emanuelenencioni/CORE23/Docs/ReportSWE4ES.docx

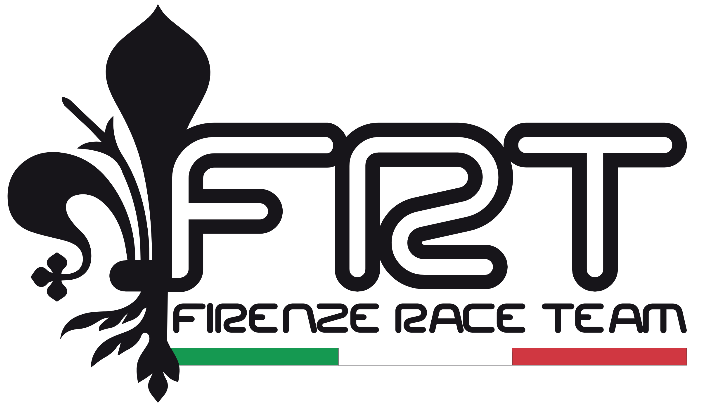
[picture p1: figure]

COMBUSTION & DRIVERLESS

FR-24

Sviluppo e Analisi Dettagliata del Software per la Main Control Unit nelle Applicazioni di Formula SAE

Candidati

Lorenzo Porcheddu

Emanuele Nencioni

Docente

Prof. Laura Carnevali

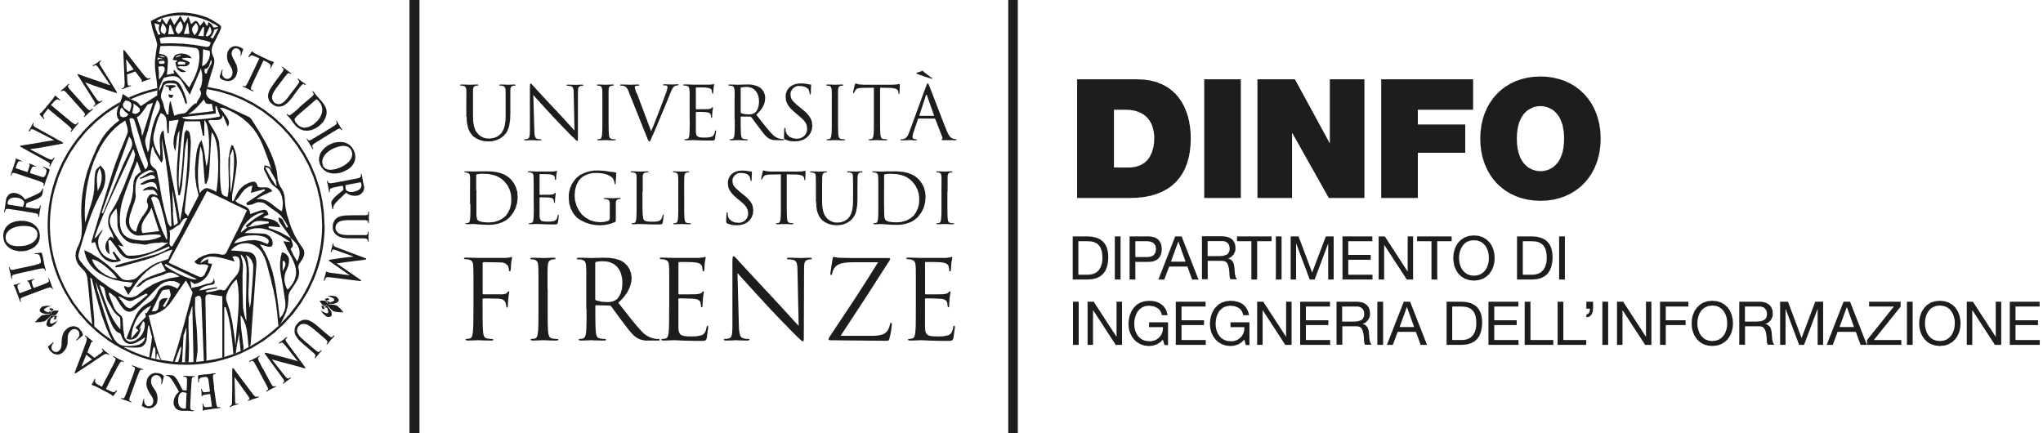
[picture p2: figure]

# Introduzione

Il Firenze Race Team è la squadra ufficiale di Formula SAE e Formula Student dell’Università degli Studi di Firenze.

È un laboratorio didattico aperto agli studenti di tutte le facoltà dell’ateneo con lo scopo di progettare e realizzare una monoposto da competizione.

Visti i prossimi cambiamenti di regolamento delle competizioni di Formula Student e il futuro del mercato automobilistico, il Team ha iniziato a sviluppare il progetto di auto a guida autonoma.

L’obiettivo principale è quello di partecipare nel 2024 alla competizione di FS-East con la vettura a combustione, per poi scendere in pista nella categoria 1D di Formula ATA con la vettura driverless.

Canditati

Emanuele Nencioni: Head of Autonomous Department – Vision & System Integration

Lorenzo Porcheddu: Head of Electronics & Controls Department

# Presentazione del Progetto e Obiettivi

La Formula Student è una competizione internazionale in cui squadre di studenti universitari si sfidano nella progettazione e costruzione di automobili da corsa monoposto. In questo progetto di Software Engineering, ci concentreremo sulla programmazione di una scheda elettronica personalizzata per un'auto da competizione, che combina le caratteristiche di un'automobile a combustione con tecnologie driverless.

L'obiettivo principale di questo progetto è sviluppare un sistema di controllo elettronico in grado di gestire il funzionamento del motore, la gestione delle velocità, il controllo del volante, il sistema di frenata, la gestione dell'alimentazione e altre funzionalità essenziali per garantire prestazioni ottimali e sicurezza durante la gara.

La sfida principale consiste nella progettazione di un software che consenta all'auto di operare autonomamente, all'interno dei limiti di velocità e parametri definiti. Ciò richiederà l'integrazione di algoritmi di intelligenza artificiale, sensori avanzati, percezione dell'ambiente e decisioni di guida autonoma.

La scheda elettronica personalizzata dovrà gestire la comunicazione bidirezionale tra l'unità di controllo principale dell'automobile e i vari componenti elettronici, come il sistema di alimentazione, l'impianto di scarico, i sistemi di raffreddamento, i sensori ambientali e molti altri. La programmazione dovrà garantire una corretta interpretazione dei dati forniti dai sensori e una risposta tempestiva per garantire efficienza, sicurezza e prestazioni ottimali.

L'interazione con il pilota sarà un altro aspetto cruciale del progetto. La scheda elettronica dovrà fornire informazioni in tempo reale al pilota, come la velocità dell'auto, lo stato del motore, la temperatura e altre informazioni critiche. Sarà necessario sviluppare un'interfaccia utente intuitiva che permetta al pilota di monitorare e intervenire nel funzionamento dell'auto driverless, garantendo una guida sicura e precisa durante la competizione.

In conclusione, questo progetto di Software Engineering, riguardante la programmazione di una scheda elettronica per la Formula Student, rappresenta una sfida entusiasmante e complessa. Il suo obiettivo principale è sviluppare un sistema sofisticato in grado di controllare in modo autonomo un'automobile a combustione durante la competizione, garantendo sicurezza, efficienza e prestazioni ottimali. L'innovazione tecnologica e l'integrazione di diverse discipline quali l'ingegneria elettronica, l'intelligenza artificiale e la sicurezza informatica saranno fondamentali per il successo di questo progetto.

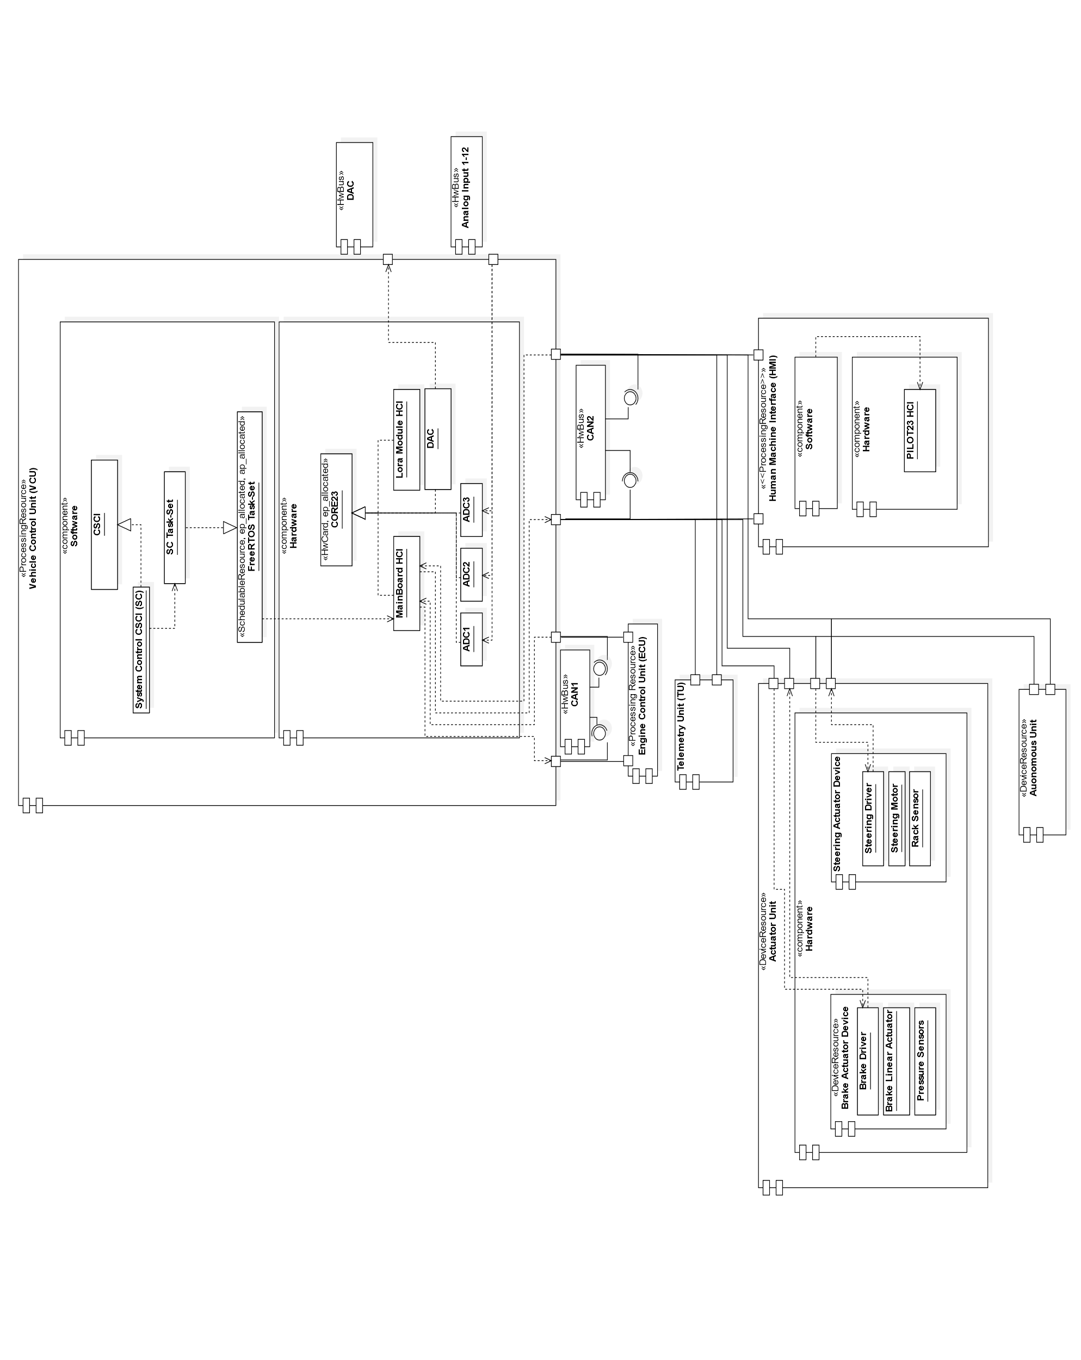
[picture p3: figure]

# Architettura del Veicolo

Come si può vedere dal diagramma di alto livello, la nostra auto integra diverse centraline elettroniche. Sono presenti anche due linee CAN bus per interconnettere il tutto, una dedicata principalmente al motore e l’altra invece al sistema autonomo. Questa suddivisione si rende necessaria data la limitata larghezza di banda disponibile, pari a 1Mbit/s di massimo teorico per ogni linea. In realtà si cerca di non superare il 50% della banda in condizioni normali per evitare la saturazione del bus e il conseguente rallentamento di tutti i messaggi.

Di seguito andiamo ad elencare i componenti del nostro sistema:

- CORE23: si tratta della MCU (Main Control Unit), ovvero della scheda principale di controllo del veicolo. Tutte le altre centraline fanno sempre riferimento a lei per gestire le funzioni interconnesse. Possiede 40 tra ingressi e uscite, analogiche e digitali, che ci permettono di collegare una buona quantità di sensori. Avendo entrambe le linee CAN bus, può essere in grado di leggere una grande quantità di dati, anche dai sensori non collegati direttamente a lei. Per esempio, può leggere la temperatura del motore dalla ECU (Engine Control Unit) e inviarla alla scheda del volante, la PILOT23, per far sì che il pilota possa monitorarla. Viceversa, può leggere il segnale proveniente dal pedale dell’acceleratore e inviarlo alla ECU, che poi lo elaborerà secondo varie strategie per attuare la valvola a farfalla. Su questa scheda si concentrerà lo sviluppo del software, quindi per ora non ci dilunghiamo molto.
- PILOT23: si tratta della HMI del veicolo, infatti è posizionata dentro il volante e si occupa principalmente di gestire l’interazione con il pilota. Sul volante è posto un display, attraverso il quale si possono visualizzare varie informazioni come marcia inserita, velocità, giri motore, temperatura dell’acqua, tempo su giro, ecc. Inoltre, si occupa di leggere i pulsanti ma soprattutto i paddle e la leva della frizione, fondamentali per interagire con il cambio.
- MekTronic MKE7: si tratta della ECU (Engine Control Unit). Come suggerisce il nome, è la centralina che si occupa della gestione del motore a combustione interna; ad essa sono infatti collegati tutti i sensori del motore, come temperatura acqua, pressione turbo, ecc. Possiede una linea CAN per l’interfacciamento con il resto del veicolo, attraverso la quale invia tutta la telemetria del motore in tempo reale.
- Driver Freno: si tratta della scheda atta a gestire il motore del freno, è collegata alla linea CAN per ricevere istruzioni ed inviare dati sul suo funzionamento.
- Driver Sterzo: si tratta della scheda atta a gestire il motore dello sterzo, è collegata alla linea CAN per ricevere istruzioni ed inviare dati sul suo funzionamento.
- AIM EVO 5: si tratta della scheda che ha il compito di registrare e memorizzare tutte le informazioni del veicolo, in tempo reale. Memorizza tutti i dati inviati su entrambe le linee CAN, inoltre ha diversi sensori aggiuntivi collegati, i quali vengono letti e memorizzati. Alla bisogna è possibile inviare i dati di questi sensori sulle linee CAN.
- PC autonomo: si tratta di un PC industriale rugged, in grado di eseguire tantissime operazioni riguardanti il sistema autonomo. Attualmente esegue ROS1 su Ubuntu 20.04, ma si progetta un futuro update a ROS2 per migliorare prestazioni e compatibilità. Monta un Intel Core i7-9700 e una scheda video NVIDIA GTX1650.

# Task set e Activity Diagram

Abbiamo quindi redatto un Activity Diagram, usando il software StarUML.

Data la dimensione del diagramma stesso, lo alleghiamo al presente report.

Di seguito, andiamo a descrivere i singoli task e le relative funzionalità

## Pedal Task

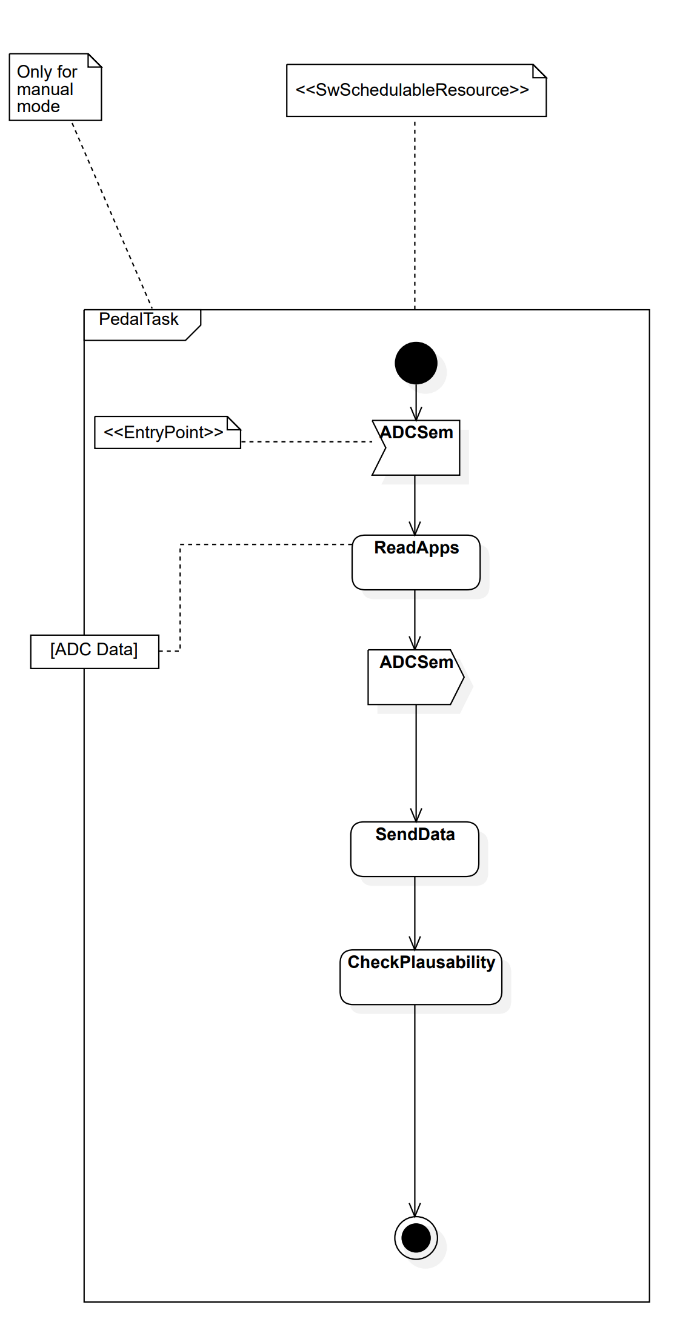
[picture p4: figure]

Si tratta del task che si occupa della gestione del comando acceleratore, inviato poi al motore a combustione. Funziona solamente durante la modalità manuale, perché durante quella autonoma si utilizza un altro task. Si prende il semaforo sull’ADC per leggere il pedale dell’acceleratore, mandiamo quindi i dati alla centralina motore attraverso il DAC. L’ultima cosa che deve fare è un controllo sulla plausibilità della lettura, per motivi di sicurezza. Leggendo due valori, se vediamo un discostamento superiore al 10% si va in errore.

## Fan Control Task

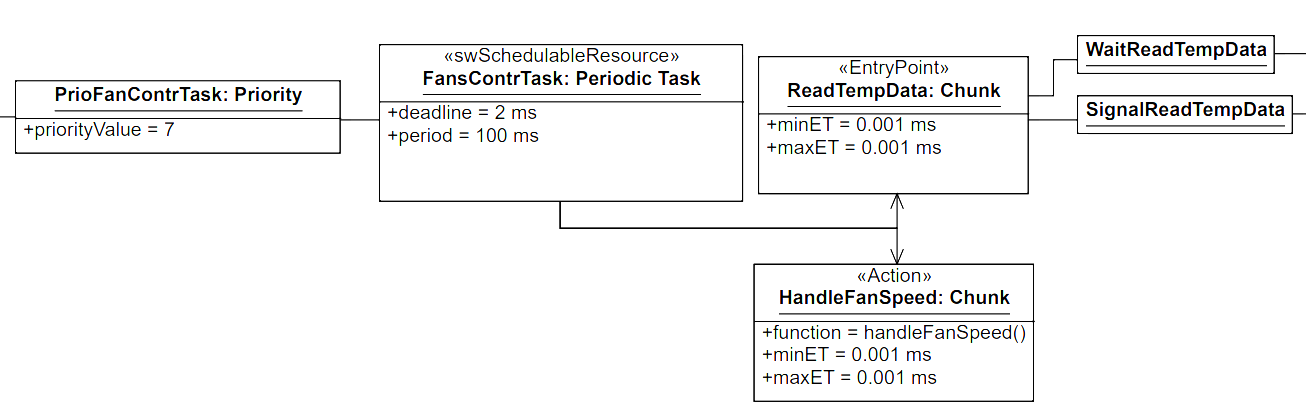
[picture p5: figure]
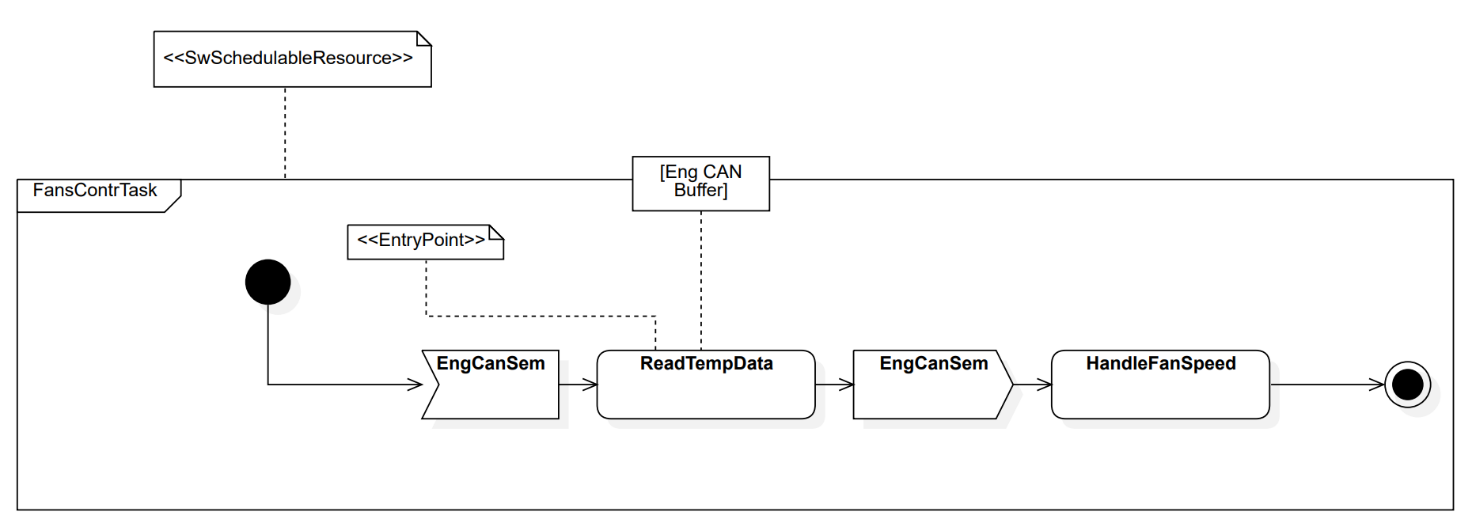
[picture p6: figure]

Questo task si occupa di gestire le ventole del radiatore e dell’intercooler, tramite modulazione PWM. Prendendo il semaforo della CAN motore leggiamo entrambe le temperature; seguendo quindi una strategia, come per esempio una rampa, andiamo a impostare il PWM in uscita. Il tutto dovrà essere gestito nel modo più efficiente possibile, perché le ventole hanno un consumo energetico elevato che potrebbe portare all’esaurimento della batteria, se utilizzate in maniera eccessiva.

## Telemetry Task

Si tratta del task che ci permette di inviare tutti i dati di telemetria, tramite protocollo LoRa. La stazione di terra, quindi, può sapere come si sta comportando la vettura in tempo reale, riconoscendo eventuali problematiche attraverso la sensoristica.

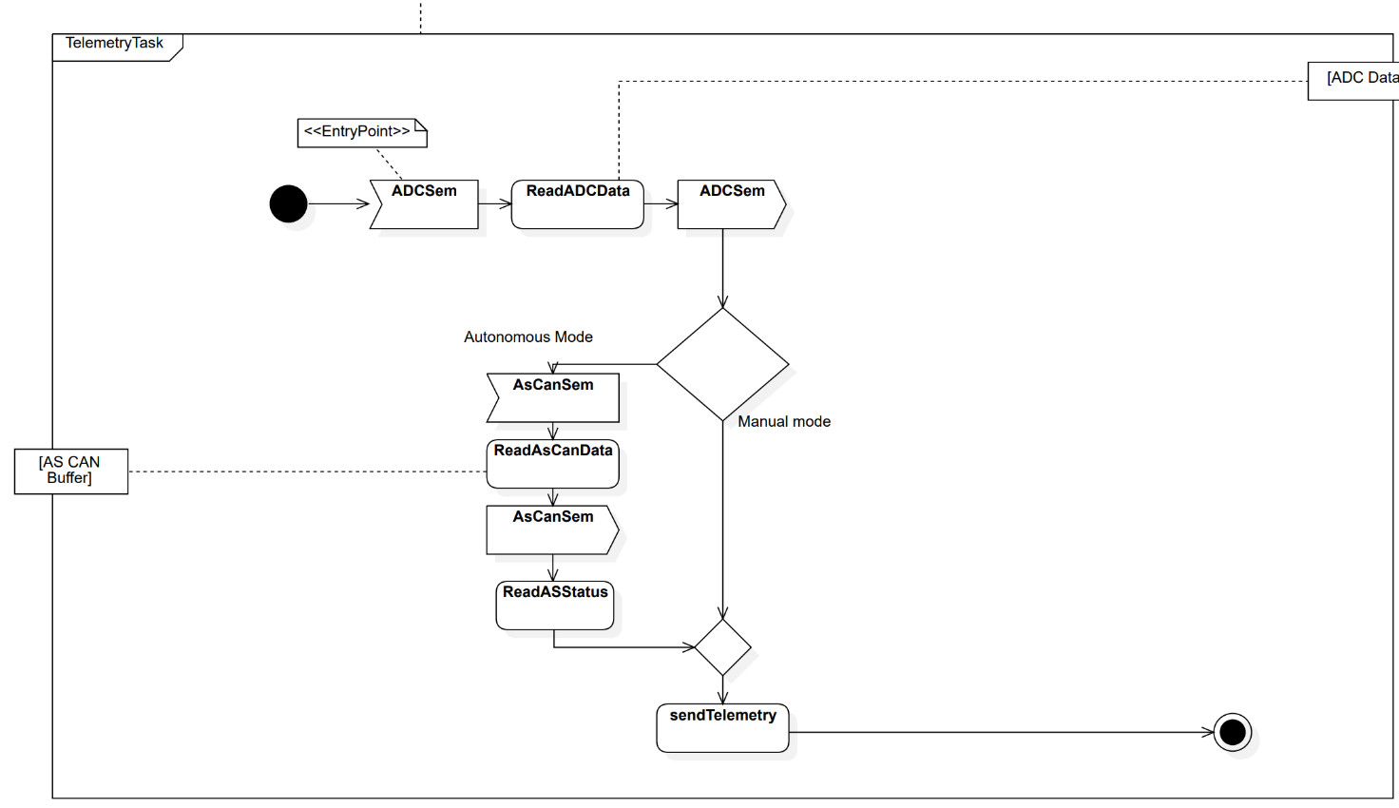
[picture p7: figure]

La telemetria è. composta principalmente dalle letture dei sensori, quindi degli ADC, ma anche i dati del sistema autonomo, nel caso di modalità driverless, tra i quali lo stato e altri valori di diagnostica. Se dovesse servire si potrebbero inviare anche altri dati riguardanti, per esempio, il motore a combustione oppure le sospensioni che non sono lette dalla CORE direttamente, ma collegate alla AIM Evo 5.

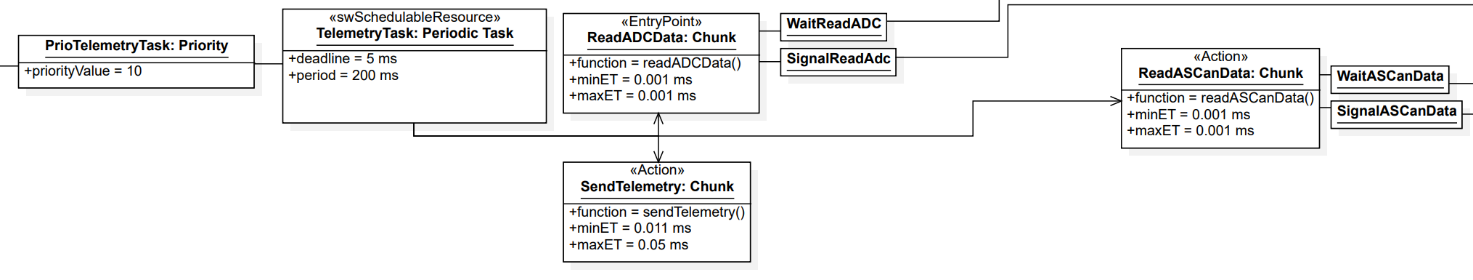
[picture p8: figure]

## Gear Task

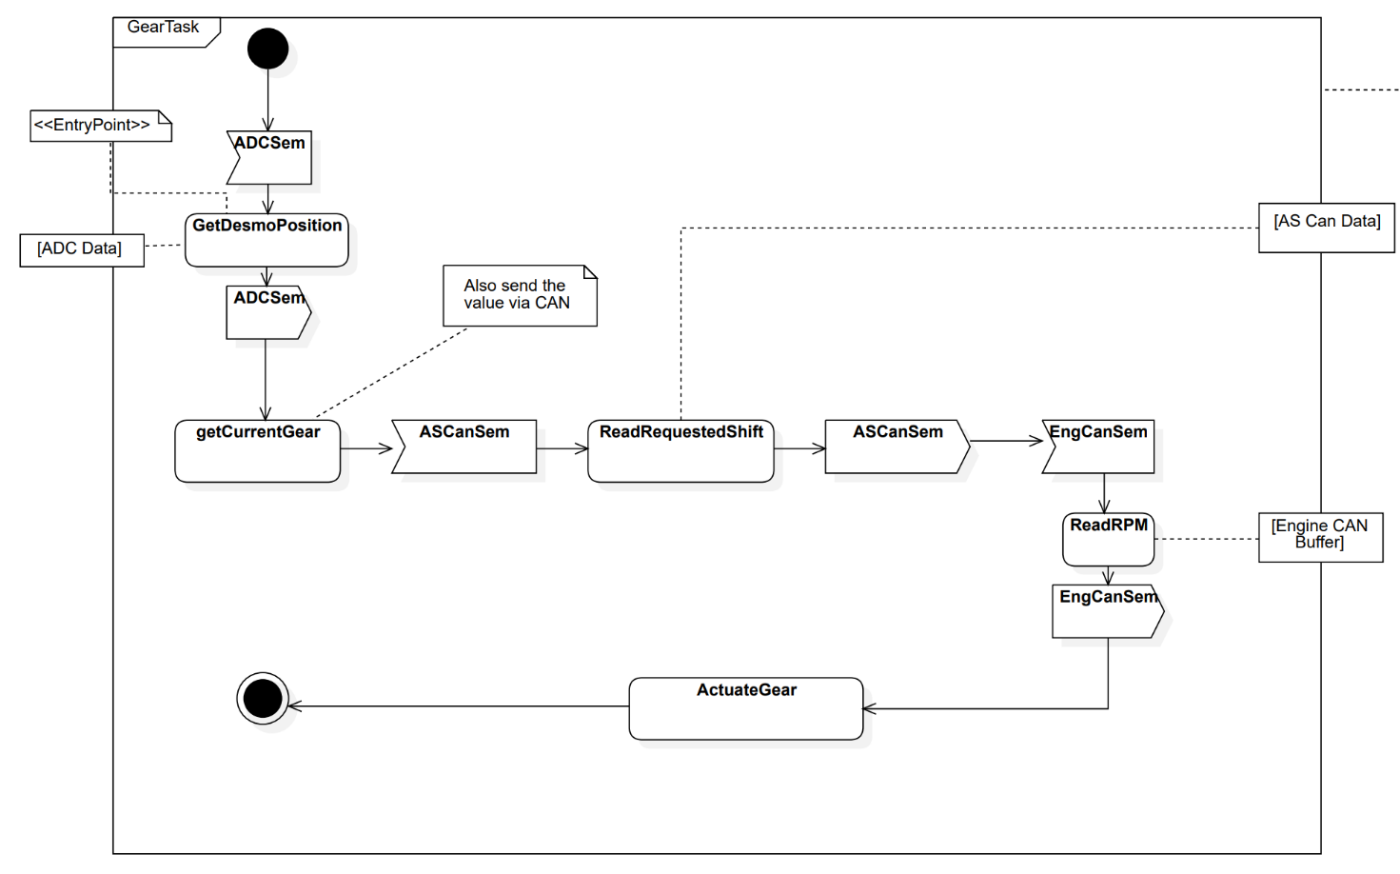
[picture p9: figure]
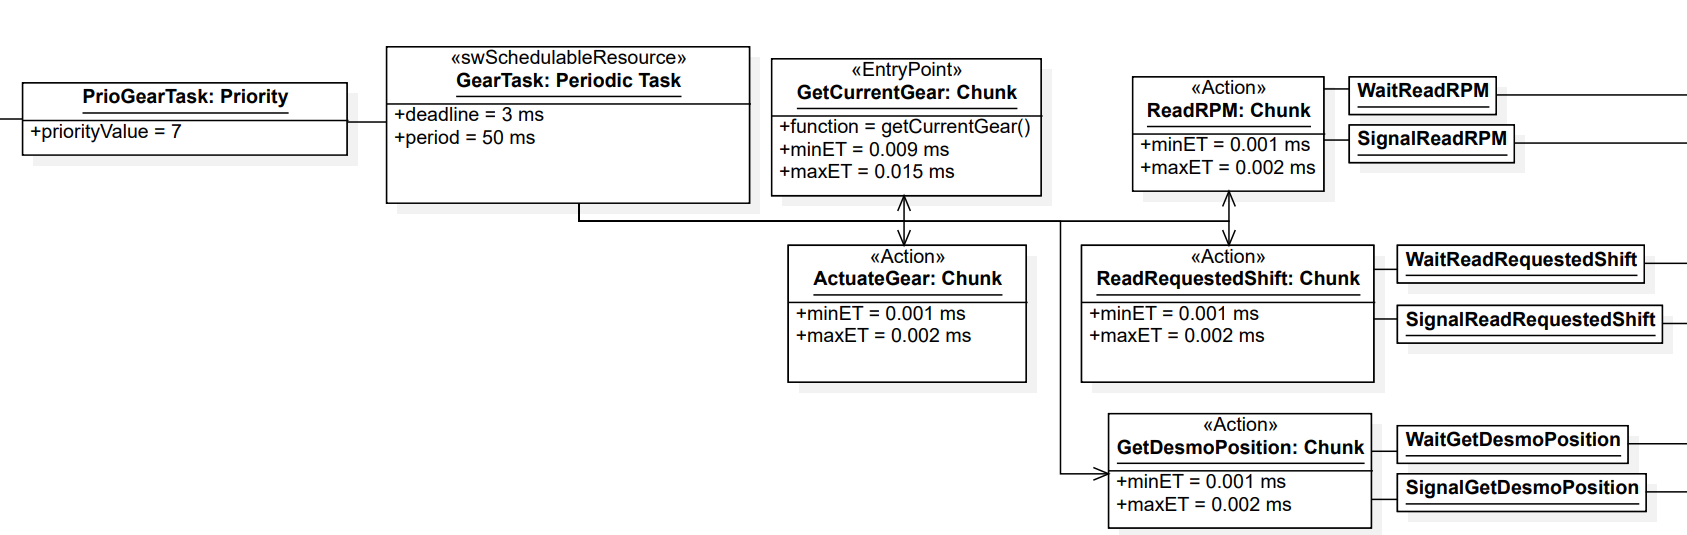
[picture p10: figure]

Si tratta del task che gestisce il cambio del motore a combustione interna. Per prima cosa andiamo a sempre leggere la marcia corrente, tramite lettura ADC e semaforo, che viene subito mandata al pilota a schermo. Controlliamo quindi se il pilota ha richiesto un cambio marcia, leggiamo il numero di giri e poi andiamo ad azionare gli attuatori per effettuare la cambiata. La lettura del numero di giri si rende necessaria ad ogni cambiata, perché ad un basso numero di giri non possiamo effettuare un’operazione di quick-shift, ovvero la cambiata rapida senza utilizzare la frizione. Sono quindi differenziate due modalità di cambiata, una con e una senza l’utilizzo della frizione.

## ADC Task

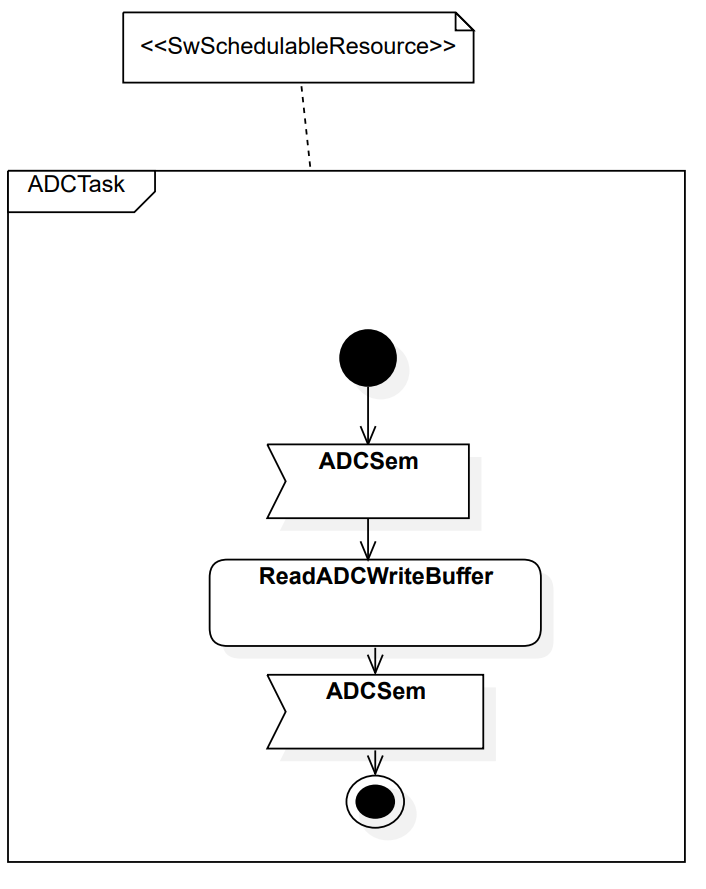
[picture p11: figure]

Questo task è tanto semplice quanto fondamentale, esso infatti ci permette di leggere gli ADC in ingresso al microcontrollore, andando ad eseguire un polling sui dati letti in continuazione (Continuous Conversion Mode). L’ADC quindi converte sempre i dati in ingresso e li memorizza in un buffer, in modalità di funzionamento circolare. I dati vecchi vengono rimpiazzati continuamente da quelli più nuovi, contemporaneamente noi li leggiamo tramite polling. In questo modo, si va a creare un semplice buffer al quale tutti i task possono accedere tramite semaforo, senza creare problemi di lettura o di accesso ai dati concorrente. L’utilizzo di altre modalità quale il polling diretto, l’interrupt o il DMA con interrupt avrebbe rallentato notevolmente l’esecuzione del codice, o causato cambi di contesto superflui.

## CAN Handler Task

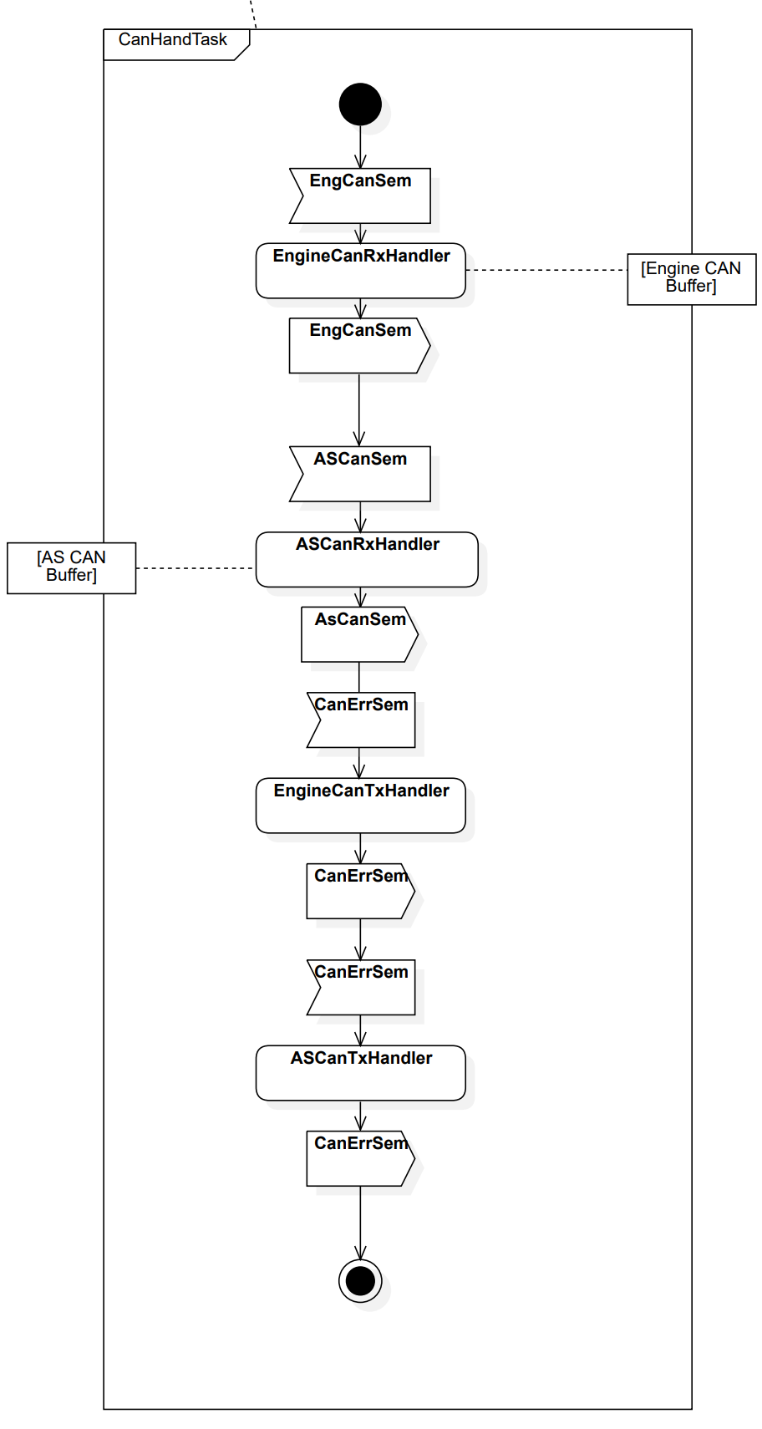
[picture p12: figure]
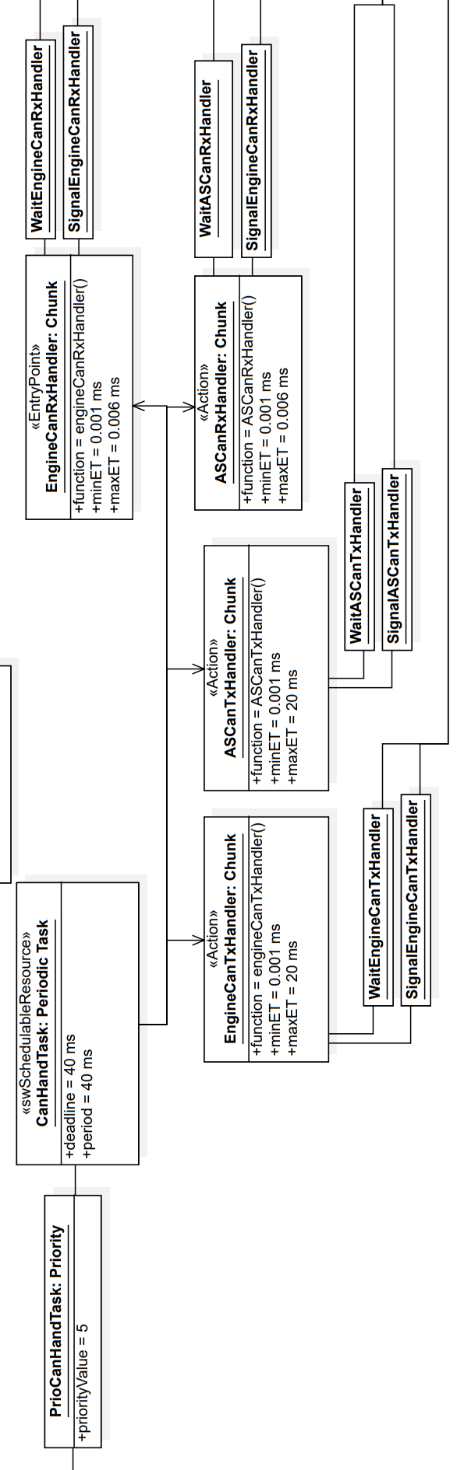
[picture p13: figure]

Si tratta del task che gestisce la comunicazione di entrambe le linee CAN. Anche in questo caso, si è scelto di non utilizzare l’interrupt per avere un codice più deterministico e per evitare anche un sovraccarico del processore, nel caso ci fossero una grande quantità di messaggi in arrivo. Il task gestisce in autonomia le code in ingresso e in uscita, tramite semafori, in modo tale da evitare situazioni di conflitto.

## AS Accelerator Task

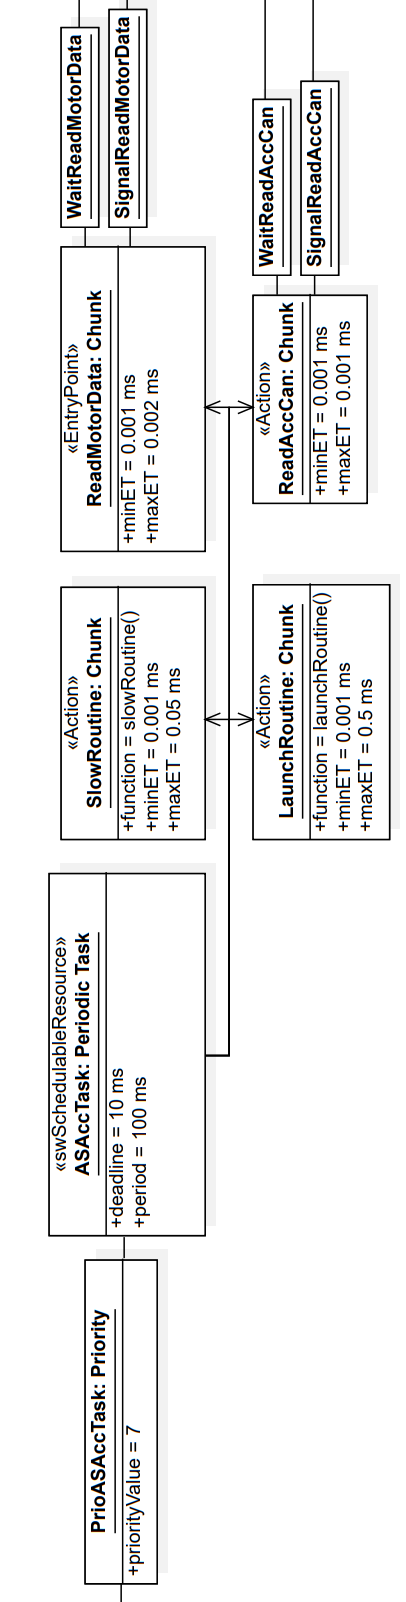
[picture p14: figure]
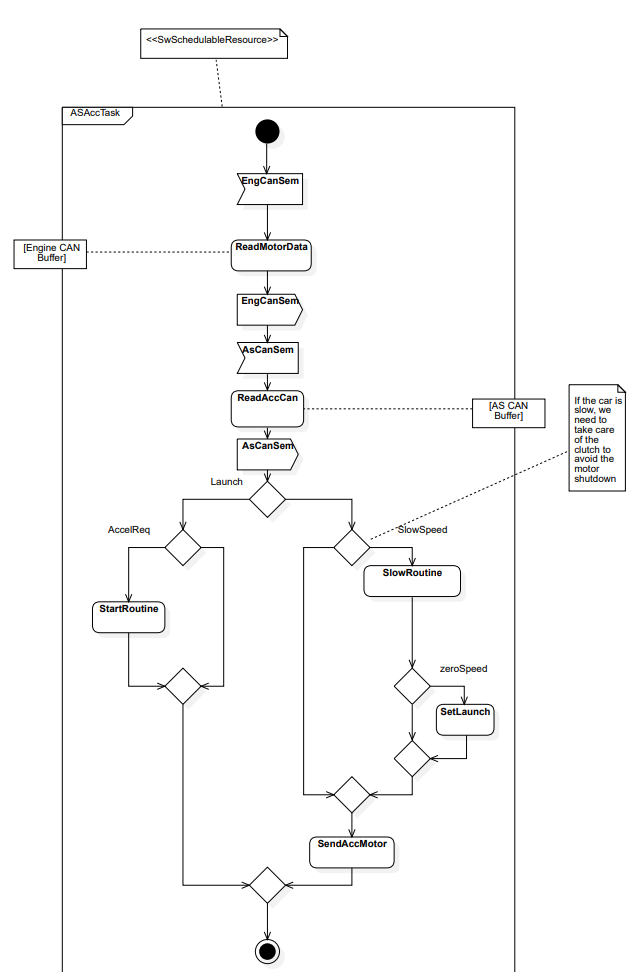
[picture p15: figure]

Si tratta del task che gestisce il comando acceleratore nel caso driverless, è infatti il PC autonomo in questo caso a fornirci l’indicazione riguardante la potenza da erogare. Il PC invia il dato via CAN e questo viene inviato alla centralina motore tramite DAC. Non essendoci il pilota umano, il task si occupa anche della gestione della frizione nelle partenze, ma anche quando la velocità e il numero di giri del motore sono bassi, per mantenere il motore acceso. I dati di tempo richiesti dai vari chunk non sono purtroppo calcolabili in quanto non è possibile esegure e testare le varie procedure senza ancora avere la vettura a disposizione, ne è stata comunque data una stima all’interno delle timeline.

## AS State Handler Task

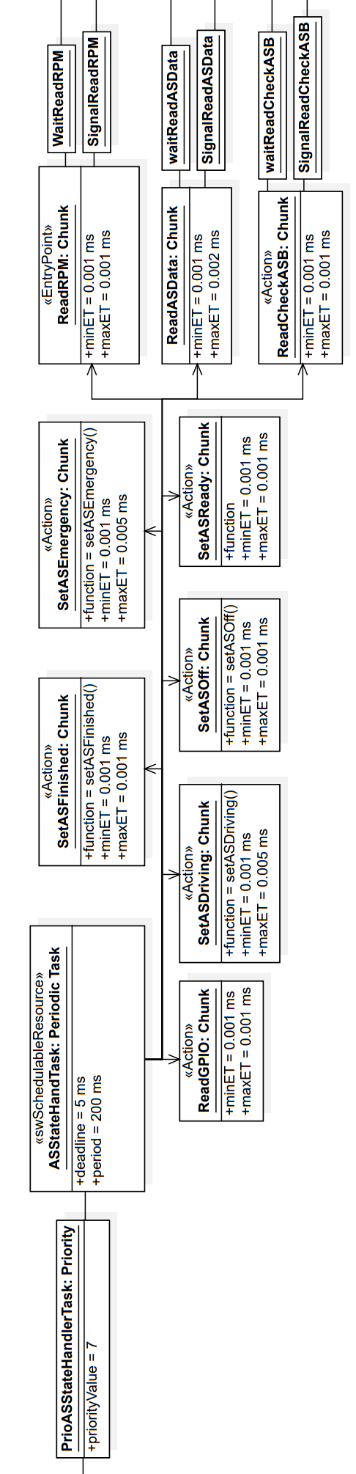
[picture p16: figure]
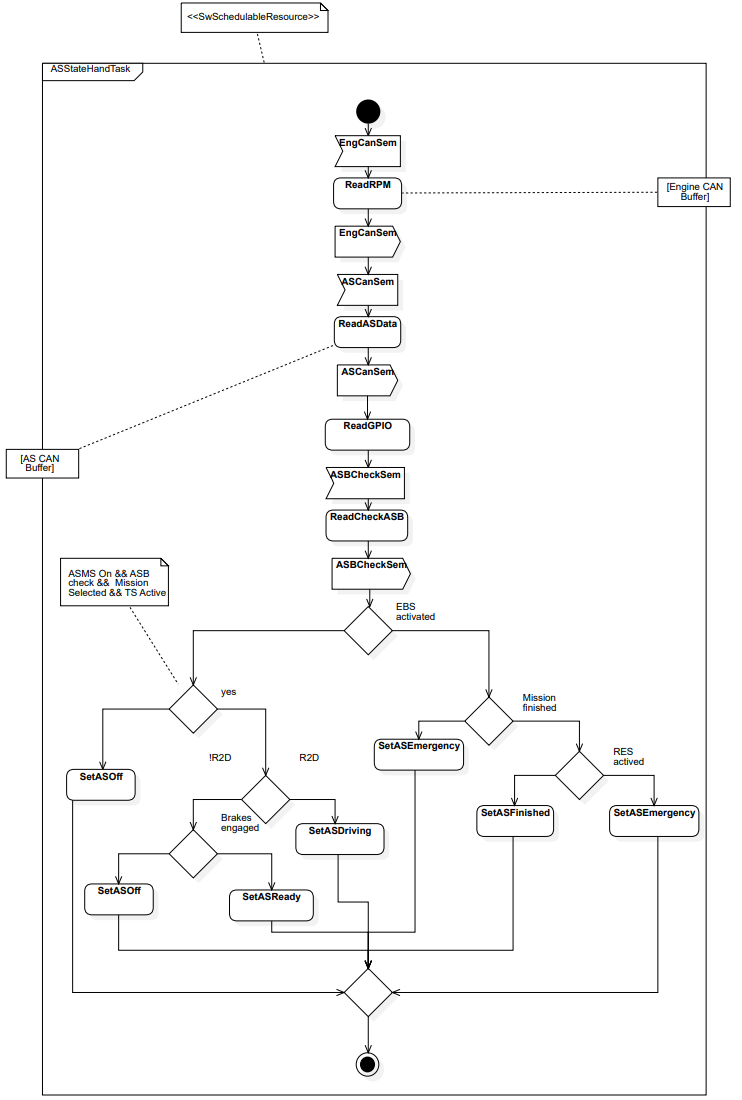
[picture p17: figure]

Si tratta del task che gestisce lo stato del sistema autonomo; infatti, durante la competizione driverless, la vettura deve rispettare una serie di stati ben precisi definiti dal regolamento. Il suo compito principale è quindi di calcolare lo stato di tutto il Sistema Autonomo a seconda dei dati che ha in tempo reale sulla macchina e sull’Autonomous PC.

In particolare:

- ASOff, attualmente l’intero sistema autonomo non ha ancora eseguito uno dei seguenti passaggi o non sono state fatte delle operazioni manuali:
  - attivazione dell’Autonomous System Master Switch (ASMS), che permette di accendere tutti i sistemi di attuazione.
  - controllo dello stato dell’EBS (Emergency Brake System, ovvero il sistema di frenata di emergenza)
  - la missione non è stata selezionata
  - il motore non è stato acceso
- ASReady, tutte le operazioni precedentemente effettuate sono state attivate. Il task a questo punto precede ad aspettare l’arrivo del Signal GO da un addetto a distanza. Questo segnale viene inviato alla vettura tramite un sistema detto Remote Emergency System (RES). Il signal GO è ricevuto dalla scheda tramite un semplice GPIO. Una volta che il task rileva che il signal GO è arrivato, procede ad inviare all’Autonomous PC il messaggio che gli permette di prendere il controllo del veicolo.
- ASDriving, per essere in questo stato è sufficiente essere anche in ASReady in più si ha la marcia inserita, perciò è lo stato in cui si entra dopo che l’Autonomous PC prende il controllo della vettura e ci rimane fino alla fine della missione o una eventuale emergenza.
- ASEmergency, è stato rilevato un ingaggio del sistema di frenata di emergenza (EBS), dovuto a problemi riscontrati durante la navigazione del sistema autonomo oppure da un addetto che a distanza è capace di attivare l’EBS tramite il sistema RES. In questo stato deve essere inoltre attivata una Sirena di emergenza per 10 secondi.
- ASFinished, La missione è stata conclusa con successo.

Lo stato viene segnalato all’esterno della vettura tramite dei LED RGB posti in modo tale da essere visibili da ogni direzione. La particolare combinazione di flash o colore, definita dal regolamento della competizione della Formula SAE, indica lo stato in tempo reale di tutto il Sistema Autonomo.

## AS Error Handler Task

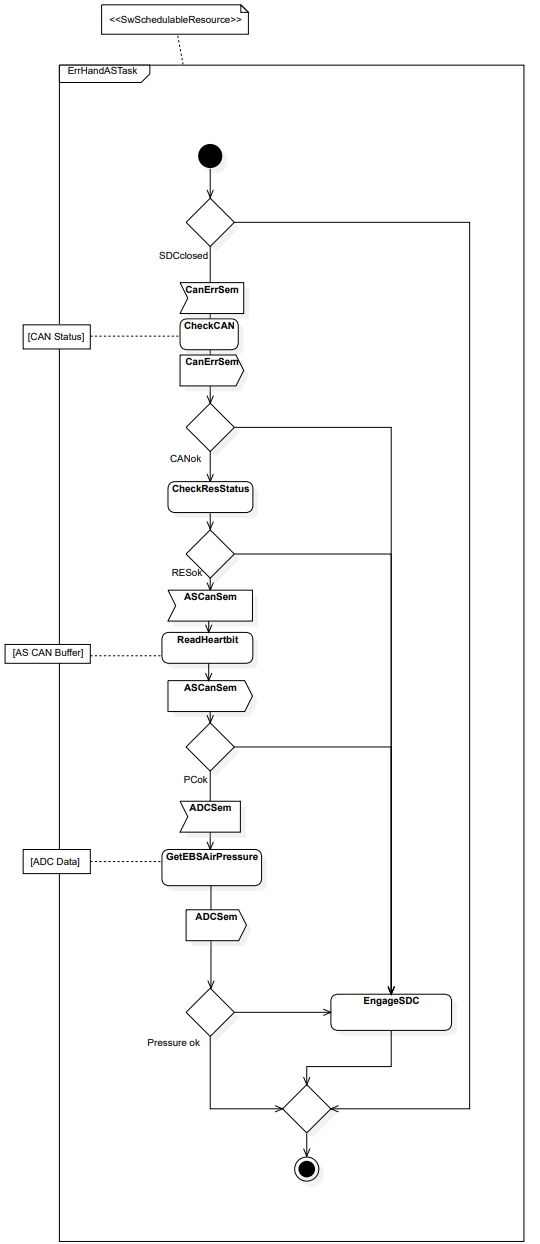
[picture p18: figure]
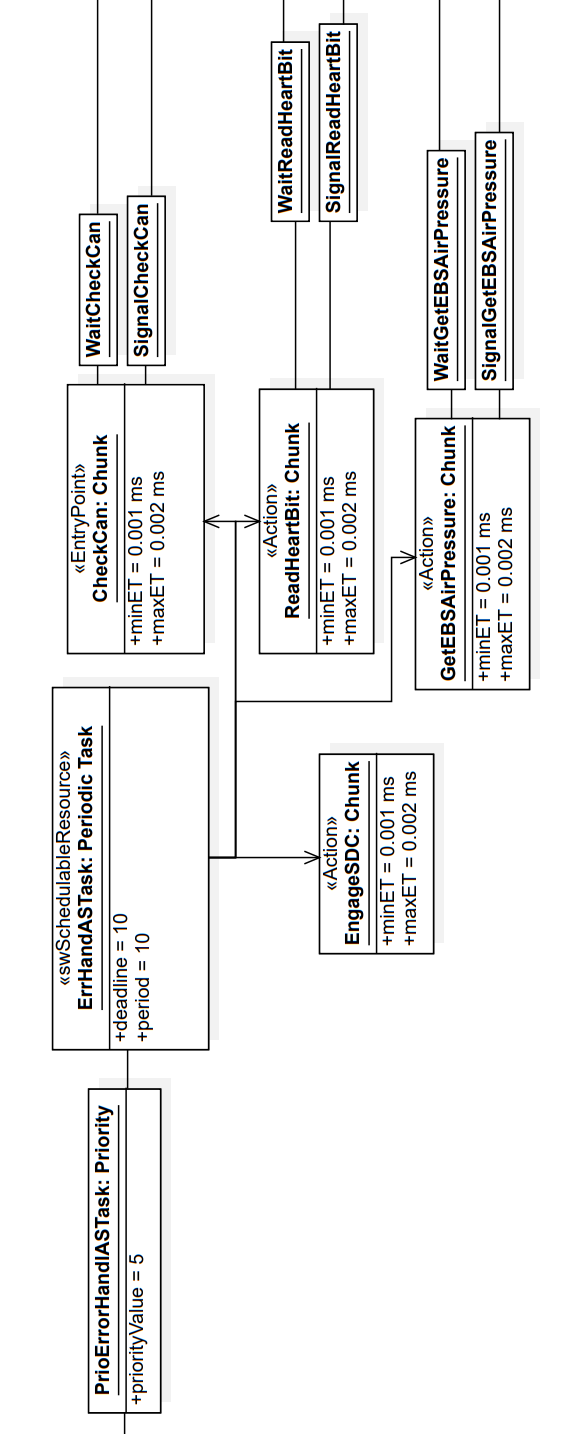
[picture p19: figure]

Si tratta del task di sicurezza della vettura, in grado di ingaggiare l'Emergency Brake System (EBS), ovvero il sistema di frenata di emergenza attuato tramite sistema pneumatico. Questo task controlla lo stato delle linee CAN, che ci sia pressione sufficiente per una frenata nel sistema EBS e che il sistema autonomo invii un Heartbit ogni 200 ms. Tutti controlli atti a garantire una risposta immediata in caso di fallimenti di una di queste parti fondamentali del veicolo. Ingaggiando l’EBS si spegne immediatamente anche il motore e la pompa della benzina collegate allo stesso circuito detto ShutDown Circuit (SDC). Task periodico con periodo molto basso per garantire minimo tempo di risposta in caso di fallimenti critici che potrebbero portare la vettura ad incidentarsi.

## Check Mode Task

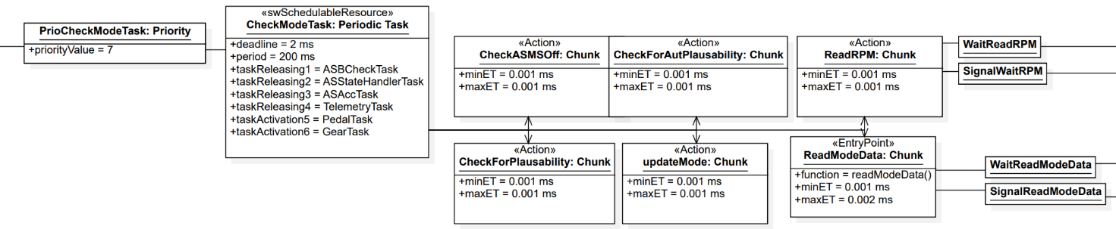
[picture p20: figure]
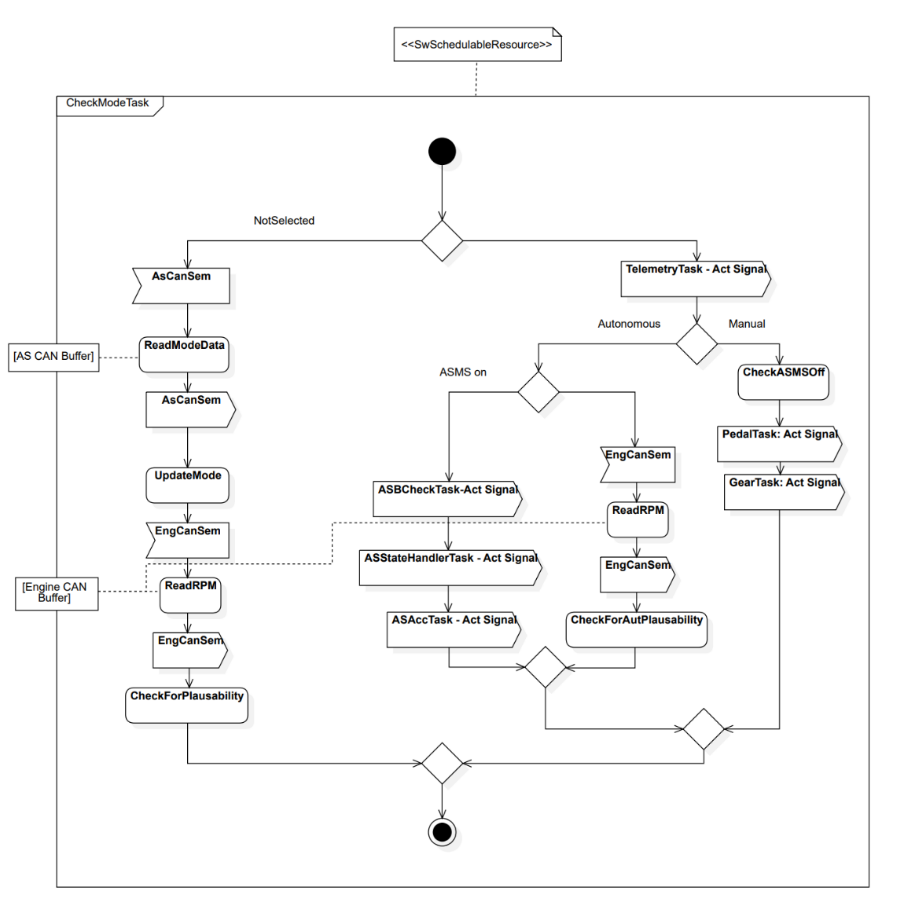
[picture p21: figure]

Si tratta del task in grado di riconoscere la modalità di funzionamento che vogliamo utilizzare, quindi manuale oppure driverless, e di conseguenza va ad attivare solamente i task necessari. In modalità manuale i task driverless non sono in funzione e viceversa, in modo tale da ottimizzare il funzionamento del programma ed eseguire solo lo stretto necessario. La modalità di funzionamento è commutata tramite un selettore al volante. Per cambiare modalità è necessario eseguire un power-cycle. Siccome il veicolo deve comunque poter essere guidato da un pilota vero, è stato necessario costruire un task che permettesse di cambiare la modalità di funzionamento della vettura: guida manuale o driverless. Questo ha permesso di ridurre il numero di task attivi simultaneamente potendo disattivare i task della guida manuale quando in modalità driverless e viceversa, diminuendo così l’overhead. Una volta scelta la modalità e, se in Autonomous, anche la missione, questo task provvederà a attivare tutti i task necessari per poi non permettere più la modifica di tale scelta fino un successivo Reset. Questa scelta è stata fatta per semplificare il lavoro del pilota in guida manuale: in questo modo se occorre eseguire dei test che richiedono un ammontare di tempo non indifferente, non si avrà bisogno di selezionare una missione o una modalità finché non si ha un totale reset della scheda stessa. Il task prevede un periodo di 200 ms, non è fondamentale la sua continua esecuzione, soprattutto dopo aver selezionato la modalità. Una possibile futura implementazione potrebbe essere anche la totale disattivazione del task una volta selezionata la modalità di funzionaamento.

## ASB Check Task

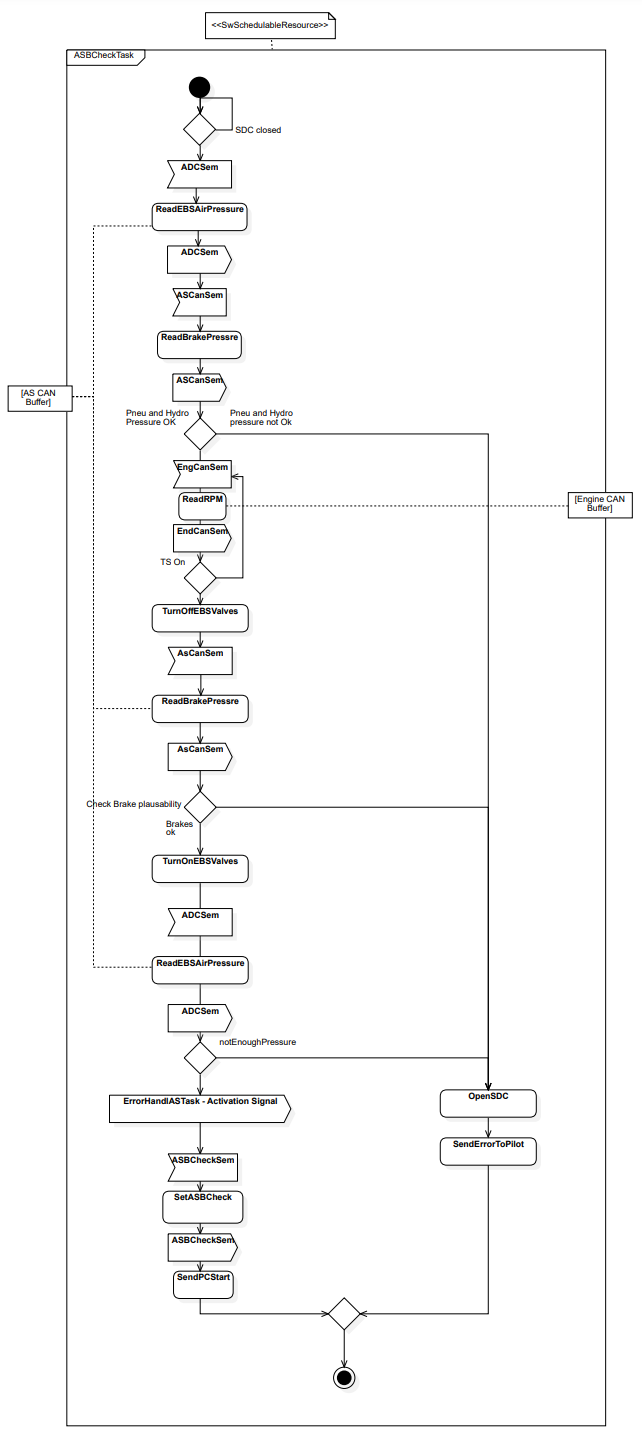
[picture p22: figure]

Si tratta del task che si occupa di fare un check iniziale dell’ Autonomous System Brake (ASB). Essendo l’impianto frenante un dispositivo di sicurezza, il regolamento ci impone un controllo sequenziale di tutti i sensori di pressione riguardanti il suddetto impianto. In caso non sia tutto ok, il task va in errore e spegne il motore, non permettendo di fatto che la vettura possa procedere con le operazioni. Inoltre, manda anche un messaggio di errore a display. Nel caso vada tutto bene invece, dà il via libera al PC per la modalità di guida.

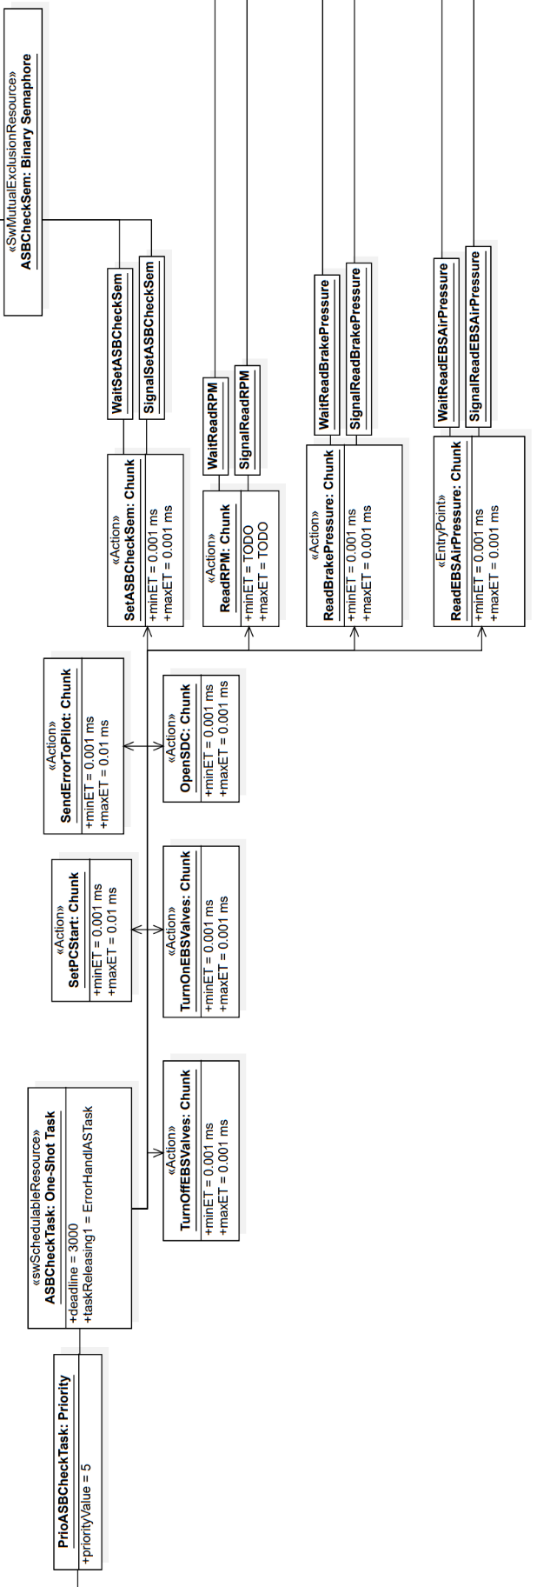
[picture p23: figure]

# Timelines e PTPN

Dopo aver completato Activity Diagram e Object Diagram, è stato scritto il codice in C e sono stati misurati i tempi di esecuzione dei vari task. Sorprendentemente, i vari chunk hanno tempi di esecuzione di qualche microsecondo, data la frequenza di clock di 216MHz del nostro microcontrollore. Le varie timeline e PTPN sono allegate insieme a questa documentazione.

Anno Accademico 20XX/20XX
