emanuelenencioni/CORE23/Docs/HighLevel.png

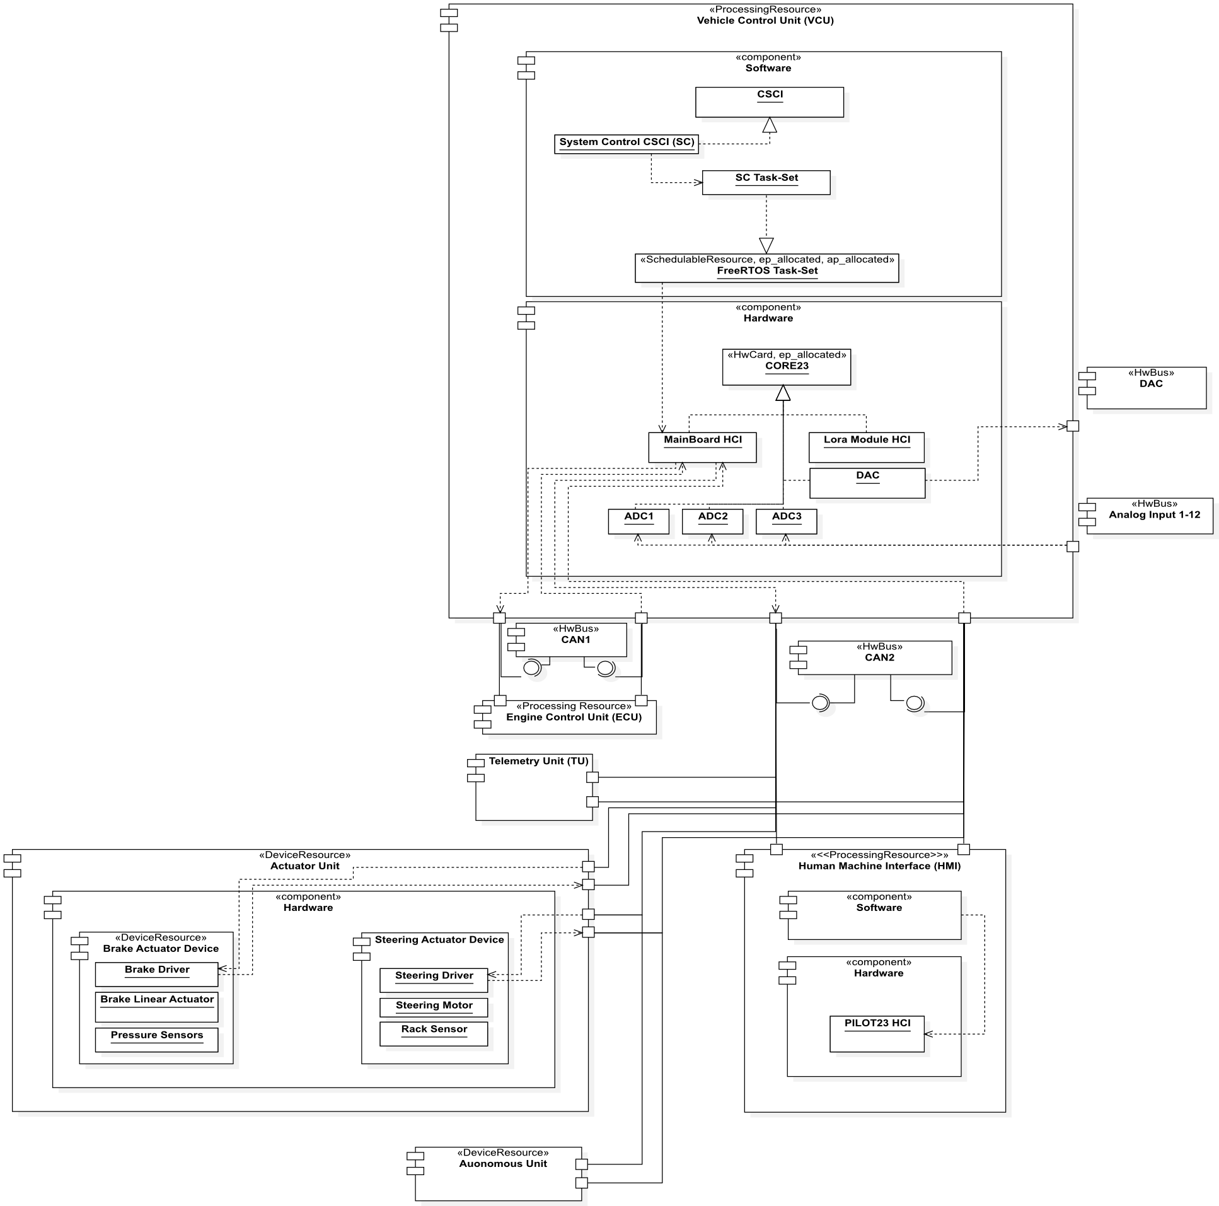
Docs/HighLevel.png
