emanuelenencioni/CORE23/Docs/PTPN/AutonomousPTPN.png

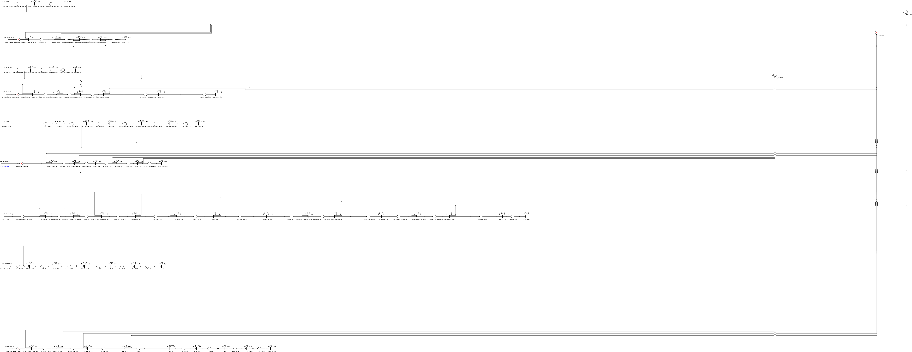
Docs/PTPN/AutonomousPTPN.png
