emanuelenencioni/CORE23/Docs/ActivityDiagram.pdf

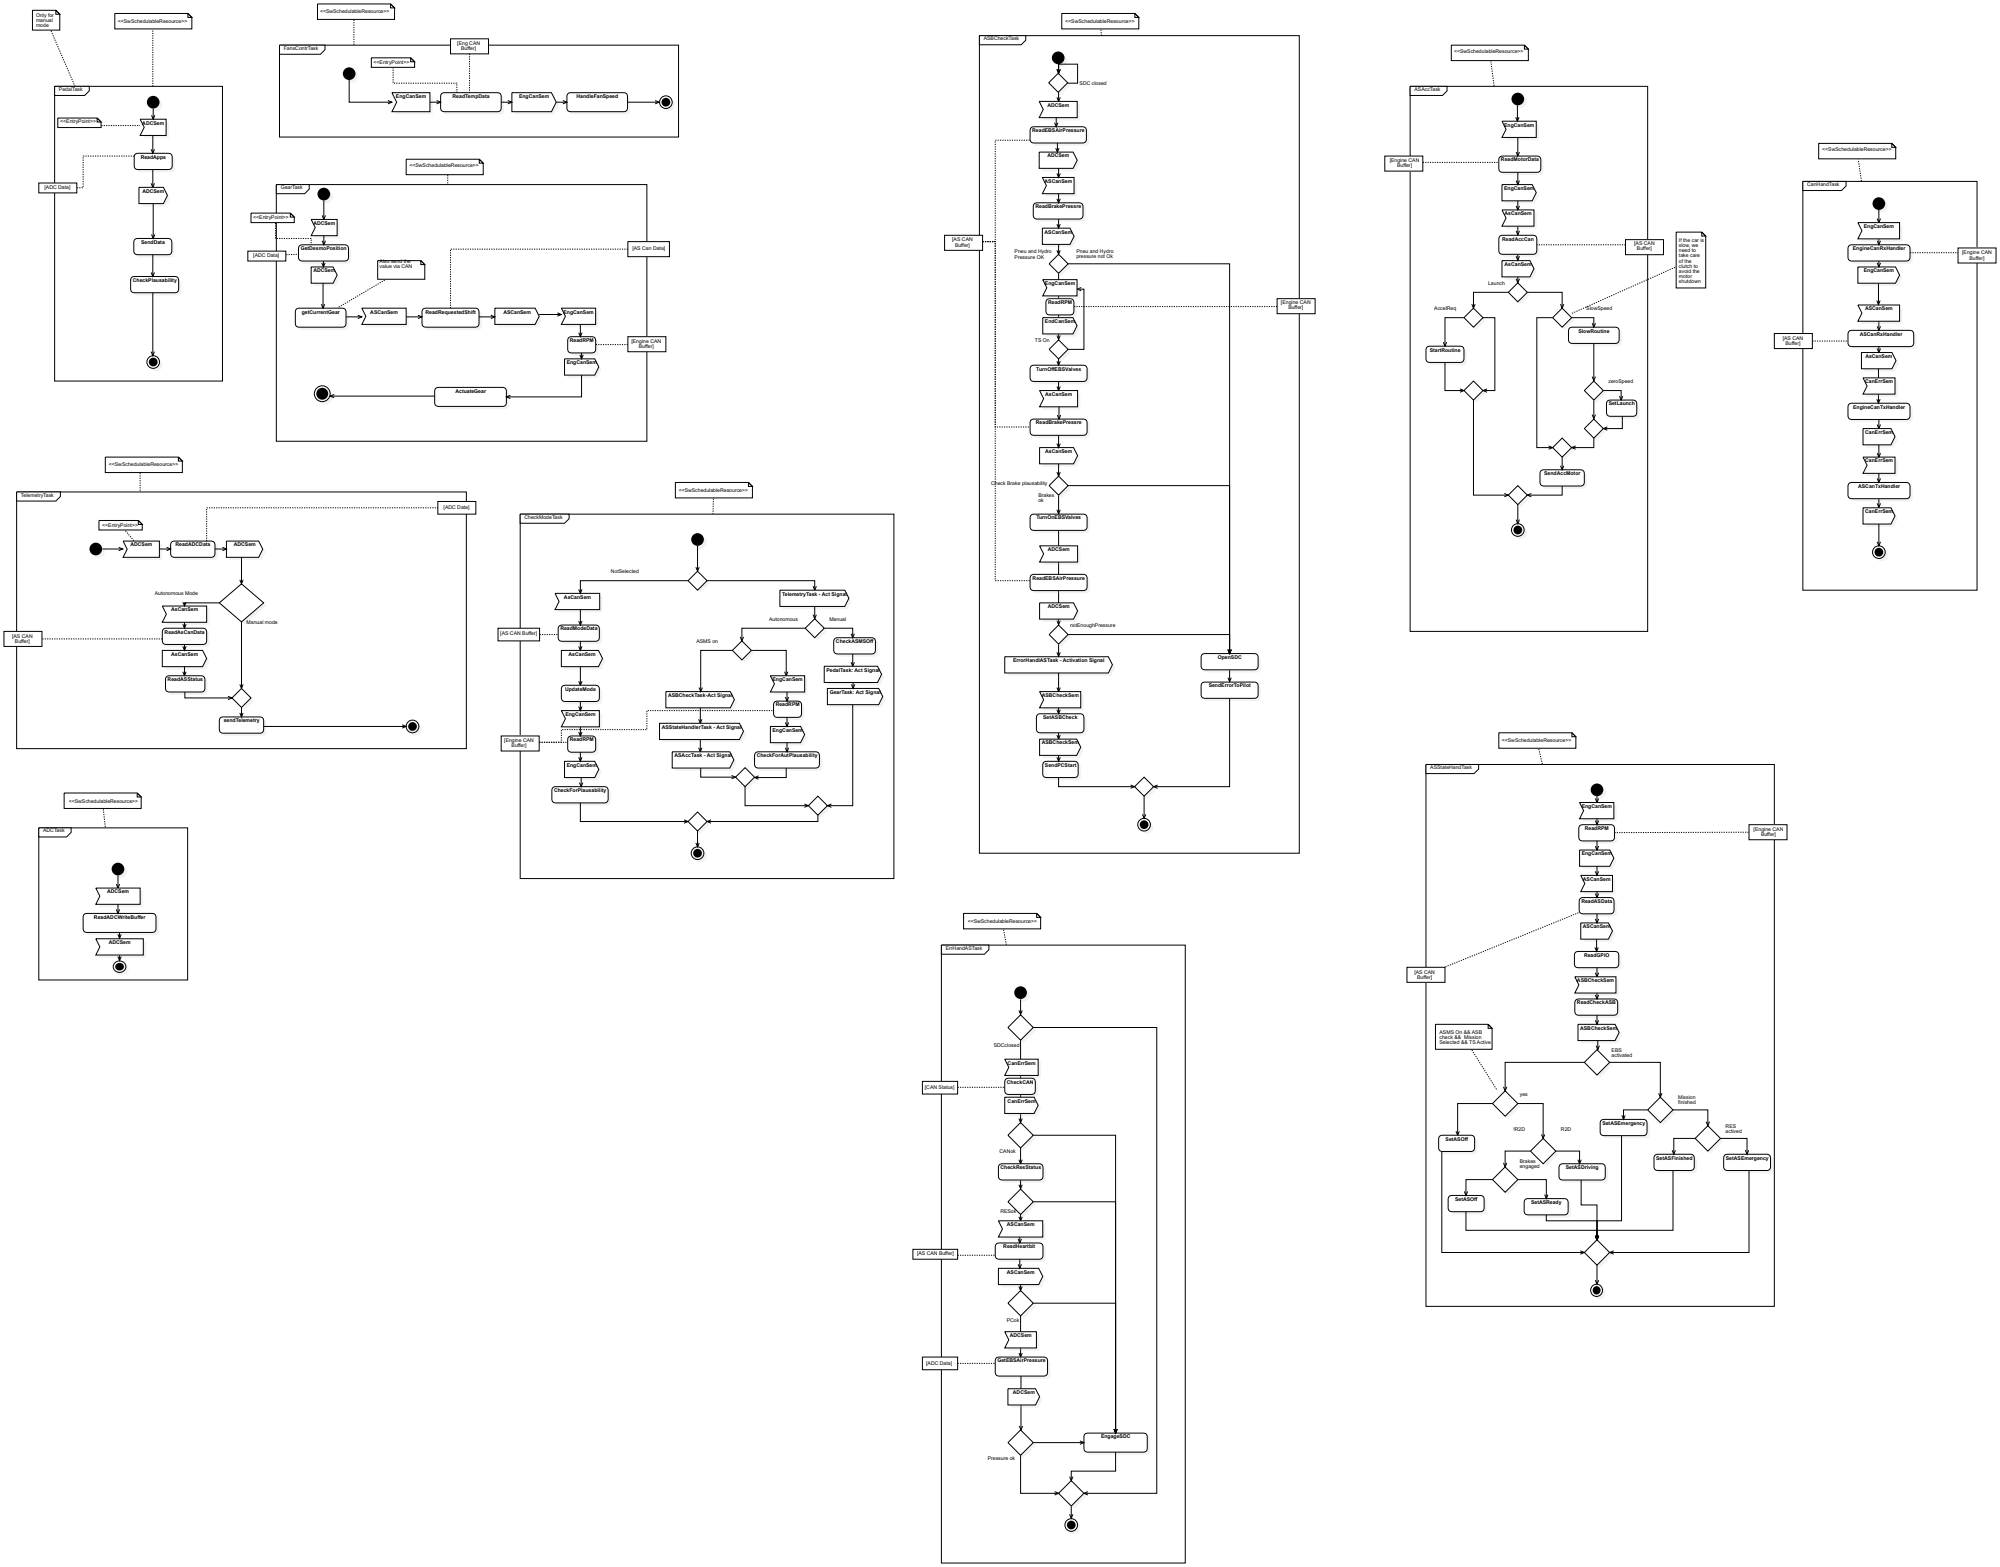
[picture p31: page 1]
TelemetryTask; PedalTask; FansContrTask; GearTask; ASBCheckTask; CheckModeTask; ADCTask; ErrHandASTask; ASStateHandTask; ASAccTask; CanHandTask; <<SwSchedulableResource>>; ReadApps; ReadAccCan; SendData; <<EntryPoint>>; ADCSem; AsCanSem; ReadADCData; sendTelemetry; [ADC Data]; [AS CAN Buffer]; ReadAsCanData; Autonomous Mode; Manual mode; EngCanSem; ReadTempData; HandleFanSpeed; [Eng CAN Buffer]; getCurrentGear; ASCanSem; ReadRequestedShift; ReadModeData; SendErrorToPilot; OpenSDC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

If the car is
slow, we
need to
take care
of the
clutch to
avoid the
motor
shutdown

[AS Can Data]

Pneu and Hydro
Pressure OK

pressure not Ok

Also send the
value via CAN

Check Brake plausability

TelemetryTask - Act Signal

[AS CAN Buffer]

ErrorHandlASTask - Activation Signal

PedalTask: Act Signal

GearTask: Act Signal

ASBCheckTask-Act Signal

ASStateHandlerTask - Act Signal

ASAccTask - Act Signal

ASMS On && ASB
check && Mission
Selected && TS Active
