emanuelenencioni/CORE23/Docs/HighLevel.pdf

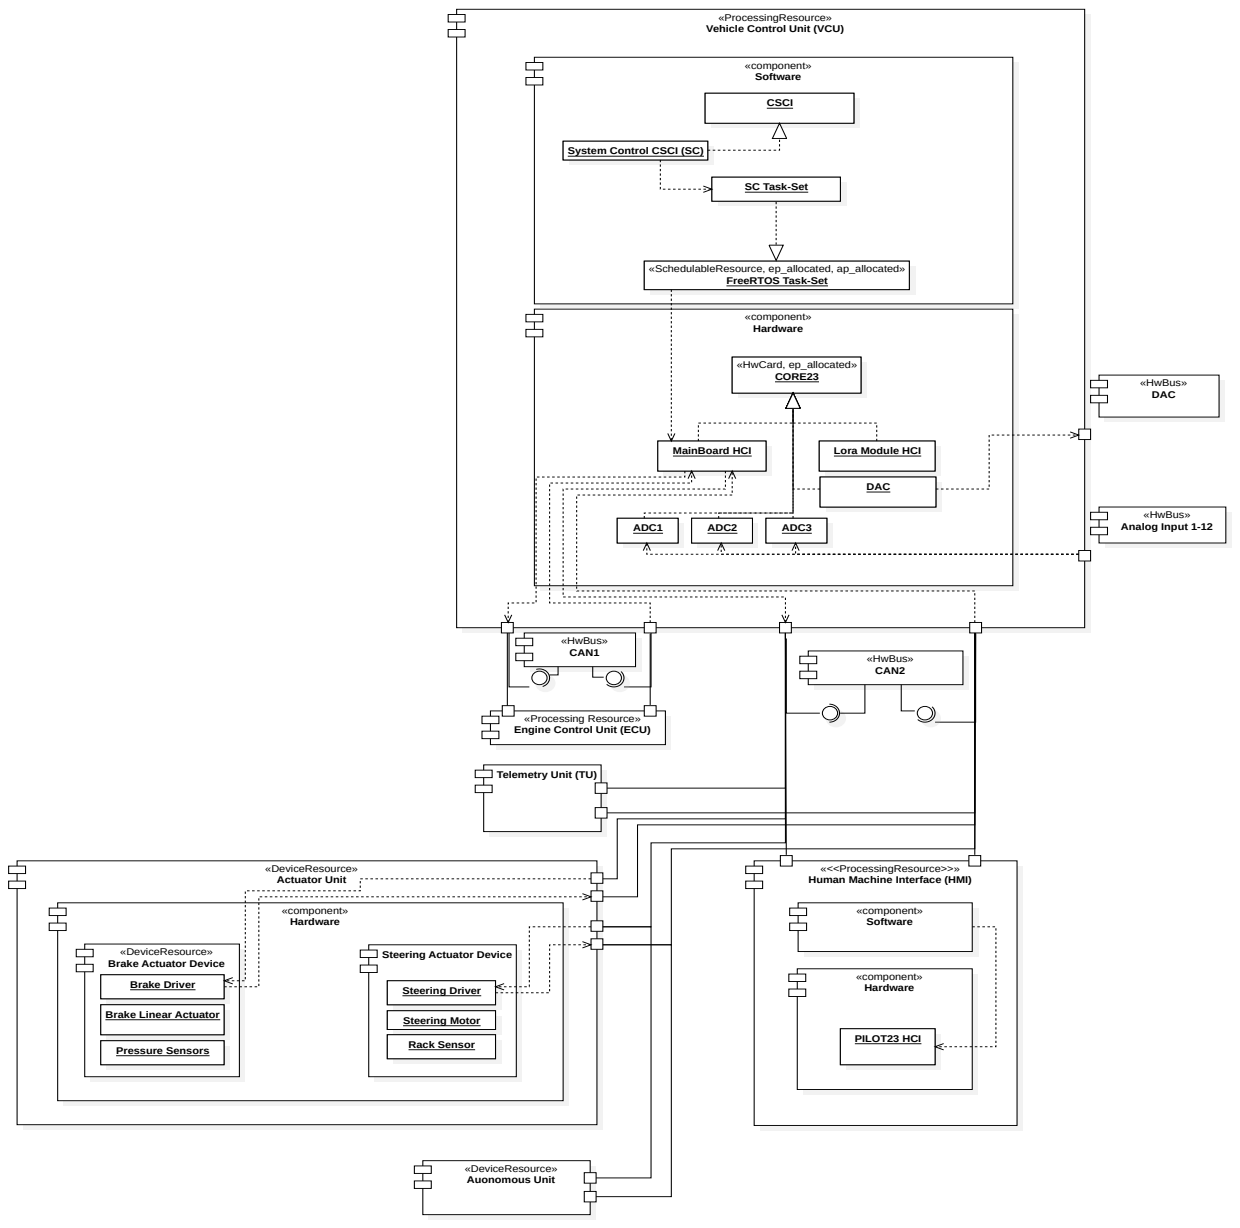
[picture p32: page 1]
«component» Software; «component» Hardware; PILOT23 HCI; «HwBus» CAN1; «DeviceResource» Actuator Unit; «HwBus» CAN2; Brake Driver; Pressure Sensors; Steering Driver; Steering Motor; Rack Sensor; «HwCard, ep_allocated» CORE23; MainBoard HCI; Lora Module HCI; «HwBus» Analog Input 1-12; «HwBus» DAC; ADC1; DAC; ADC2; ADC3; CSCI; «SchedulableResource, ep_allocated, ap_allocated»; «DeviceResource» Auonomous Unit

«ProcessingResource»
Vehicle Control Unit (VCU)

System Control CSCI (SC)

SC Task-Set

FreeRTOS Task-Set

«Processing Resource»
Engine Control Unit (ECU)

Telemetry Unit (TU)

«<<ProcessingResource>>»
Human Machine Interface (HMI)

«DeviceResource»
Brake Actuator Device

Steering Actuator Device

Brake Linear Actuator
