emanuelenencioni/CORE23/Docs/SlideCommFRT.pdf

## Communication system

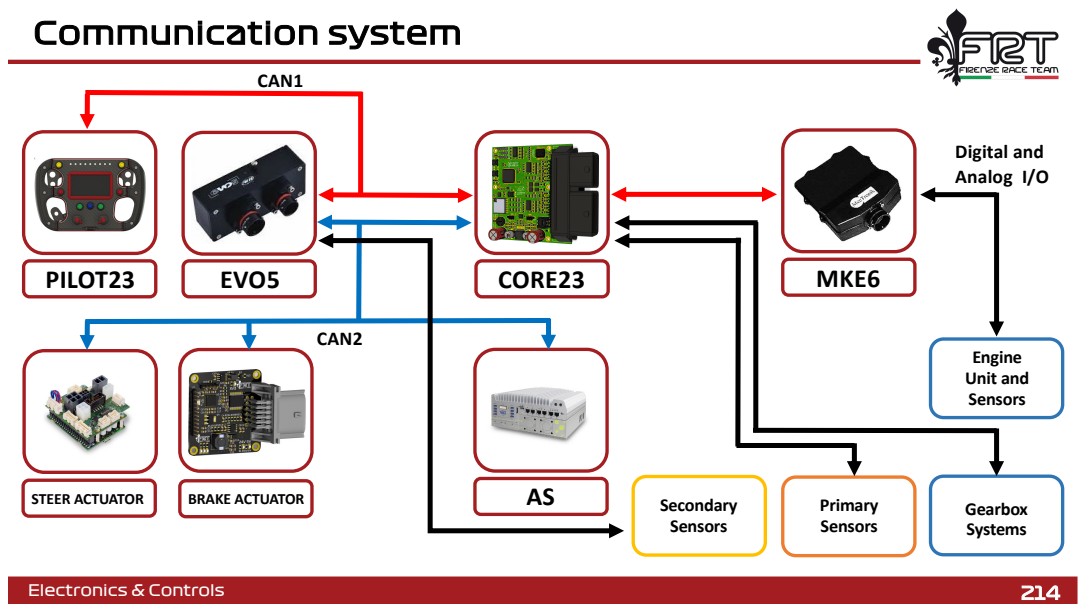
[picture p33: page 1]
Presentation title; PILOT23; EVO5; CORE23; MKE6; CAN1; Engine Unit and Sensors; Gearbox Systems; Primary Sensors; Secondary Sensors; STEER ACTUATOR; BRAKE ACTUATOR; CAN2; Digital and Analog I/O; Electronics & Controls
