emanuelenencioni/CORE23/Docs/PTPN/ManualPTPN.pdf

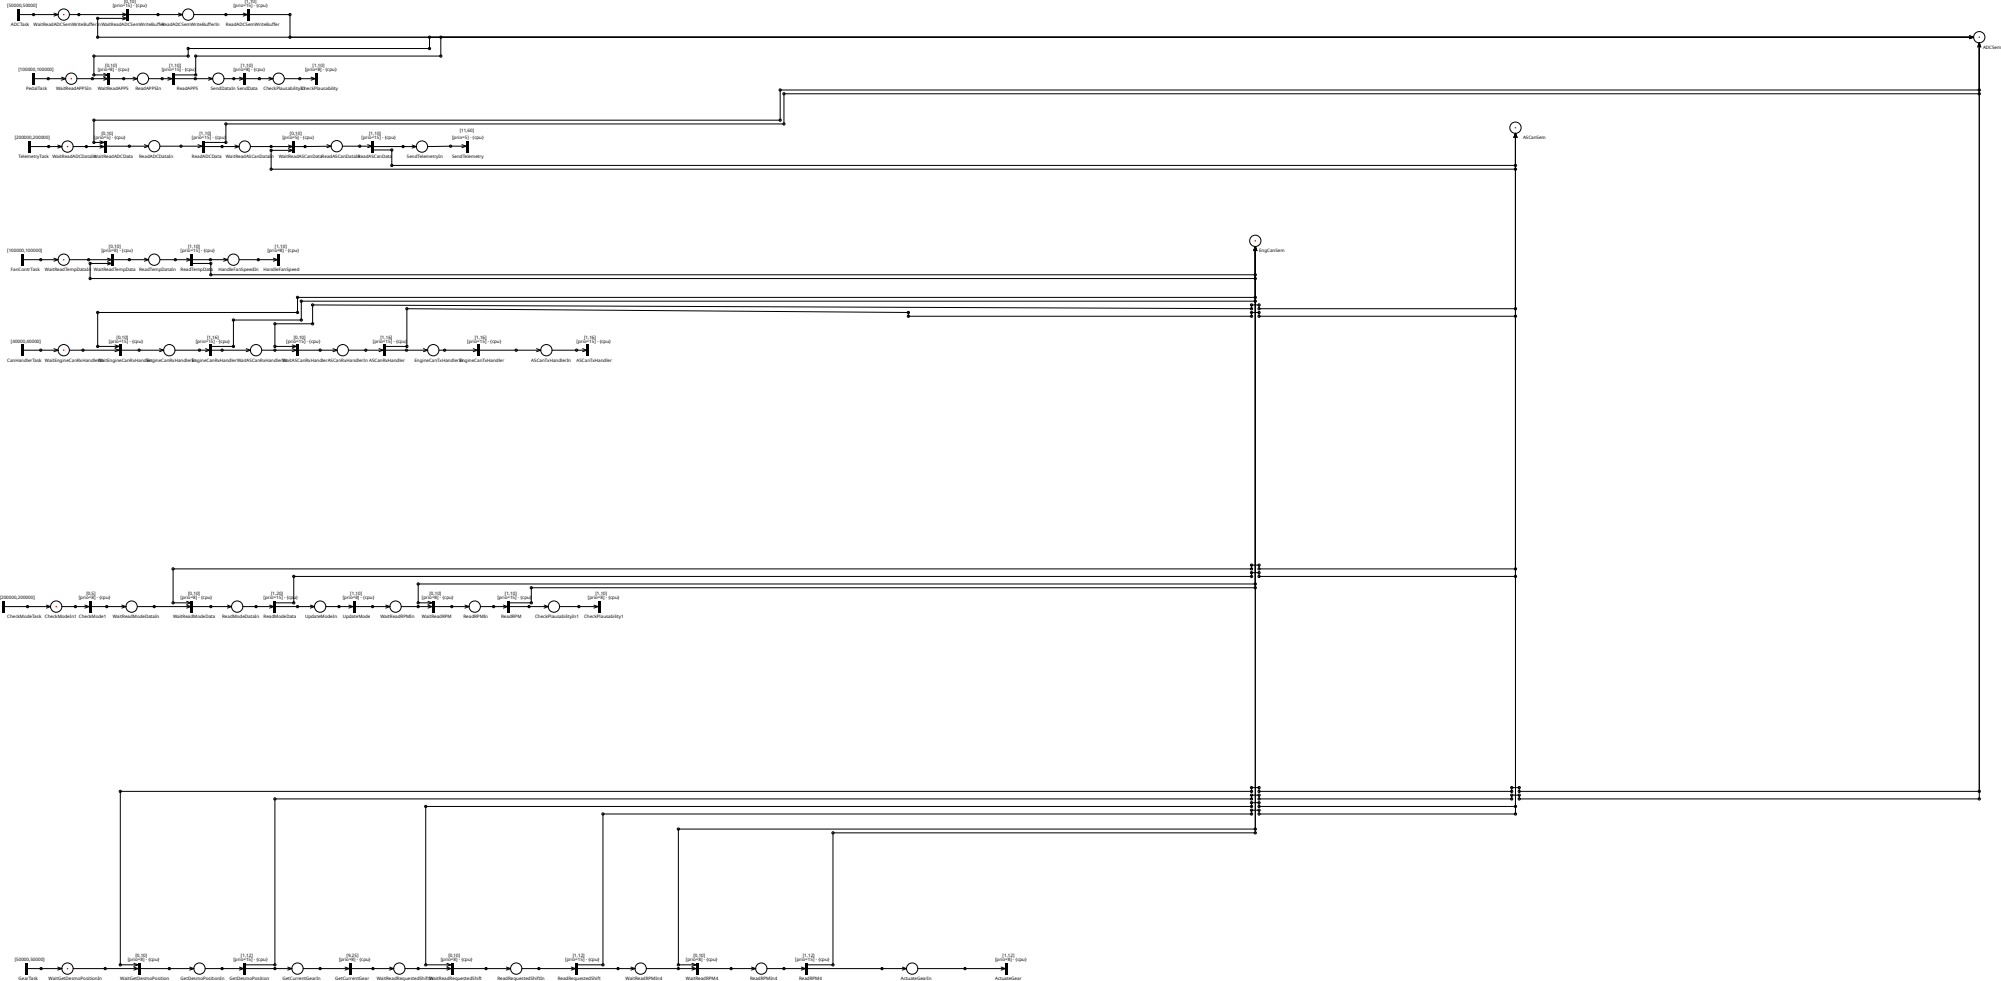
[picture p35: page 1]
ReadADCSemWriteBufferIn; ADCSem; WaitReadADCDataIn; ReadADCDataIn; WaitReadASCanDataIn; ReadASCanDataIn; ASCanSem; SendTelemetryIn; WaitReadAPPSIn; ReadAPPSIn; EngCanSem; SendDataIn; CheckPlausabilityIn; WaitReadTempDataIn; ReadTempDataIn; HandleFanSpeedIn; WaitEngineCanRxHandlerIn; EngineCanRxHandlerIn; WaitASCanRxHandlerIn; ASCanRxHandlerIn; EngineCanTxHandlerIn; ASCanTxHandlerIn; CheckModeIn1; WaitReadModeDataIn; ReadModeDataIn; UpdateModeIn; WaitReadRPMIn; ReadRPMIn; CheckPlausabilityIn1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
