emanuelenencioni/CORE23/Docs/Timelines.pdf

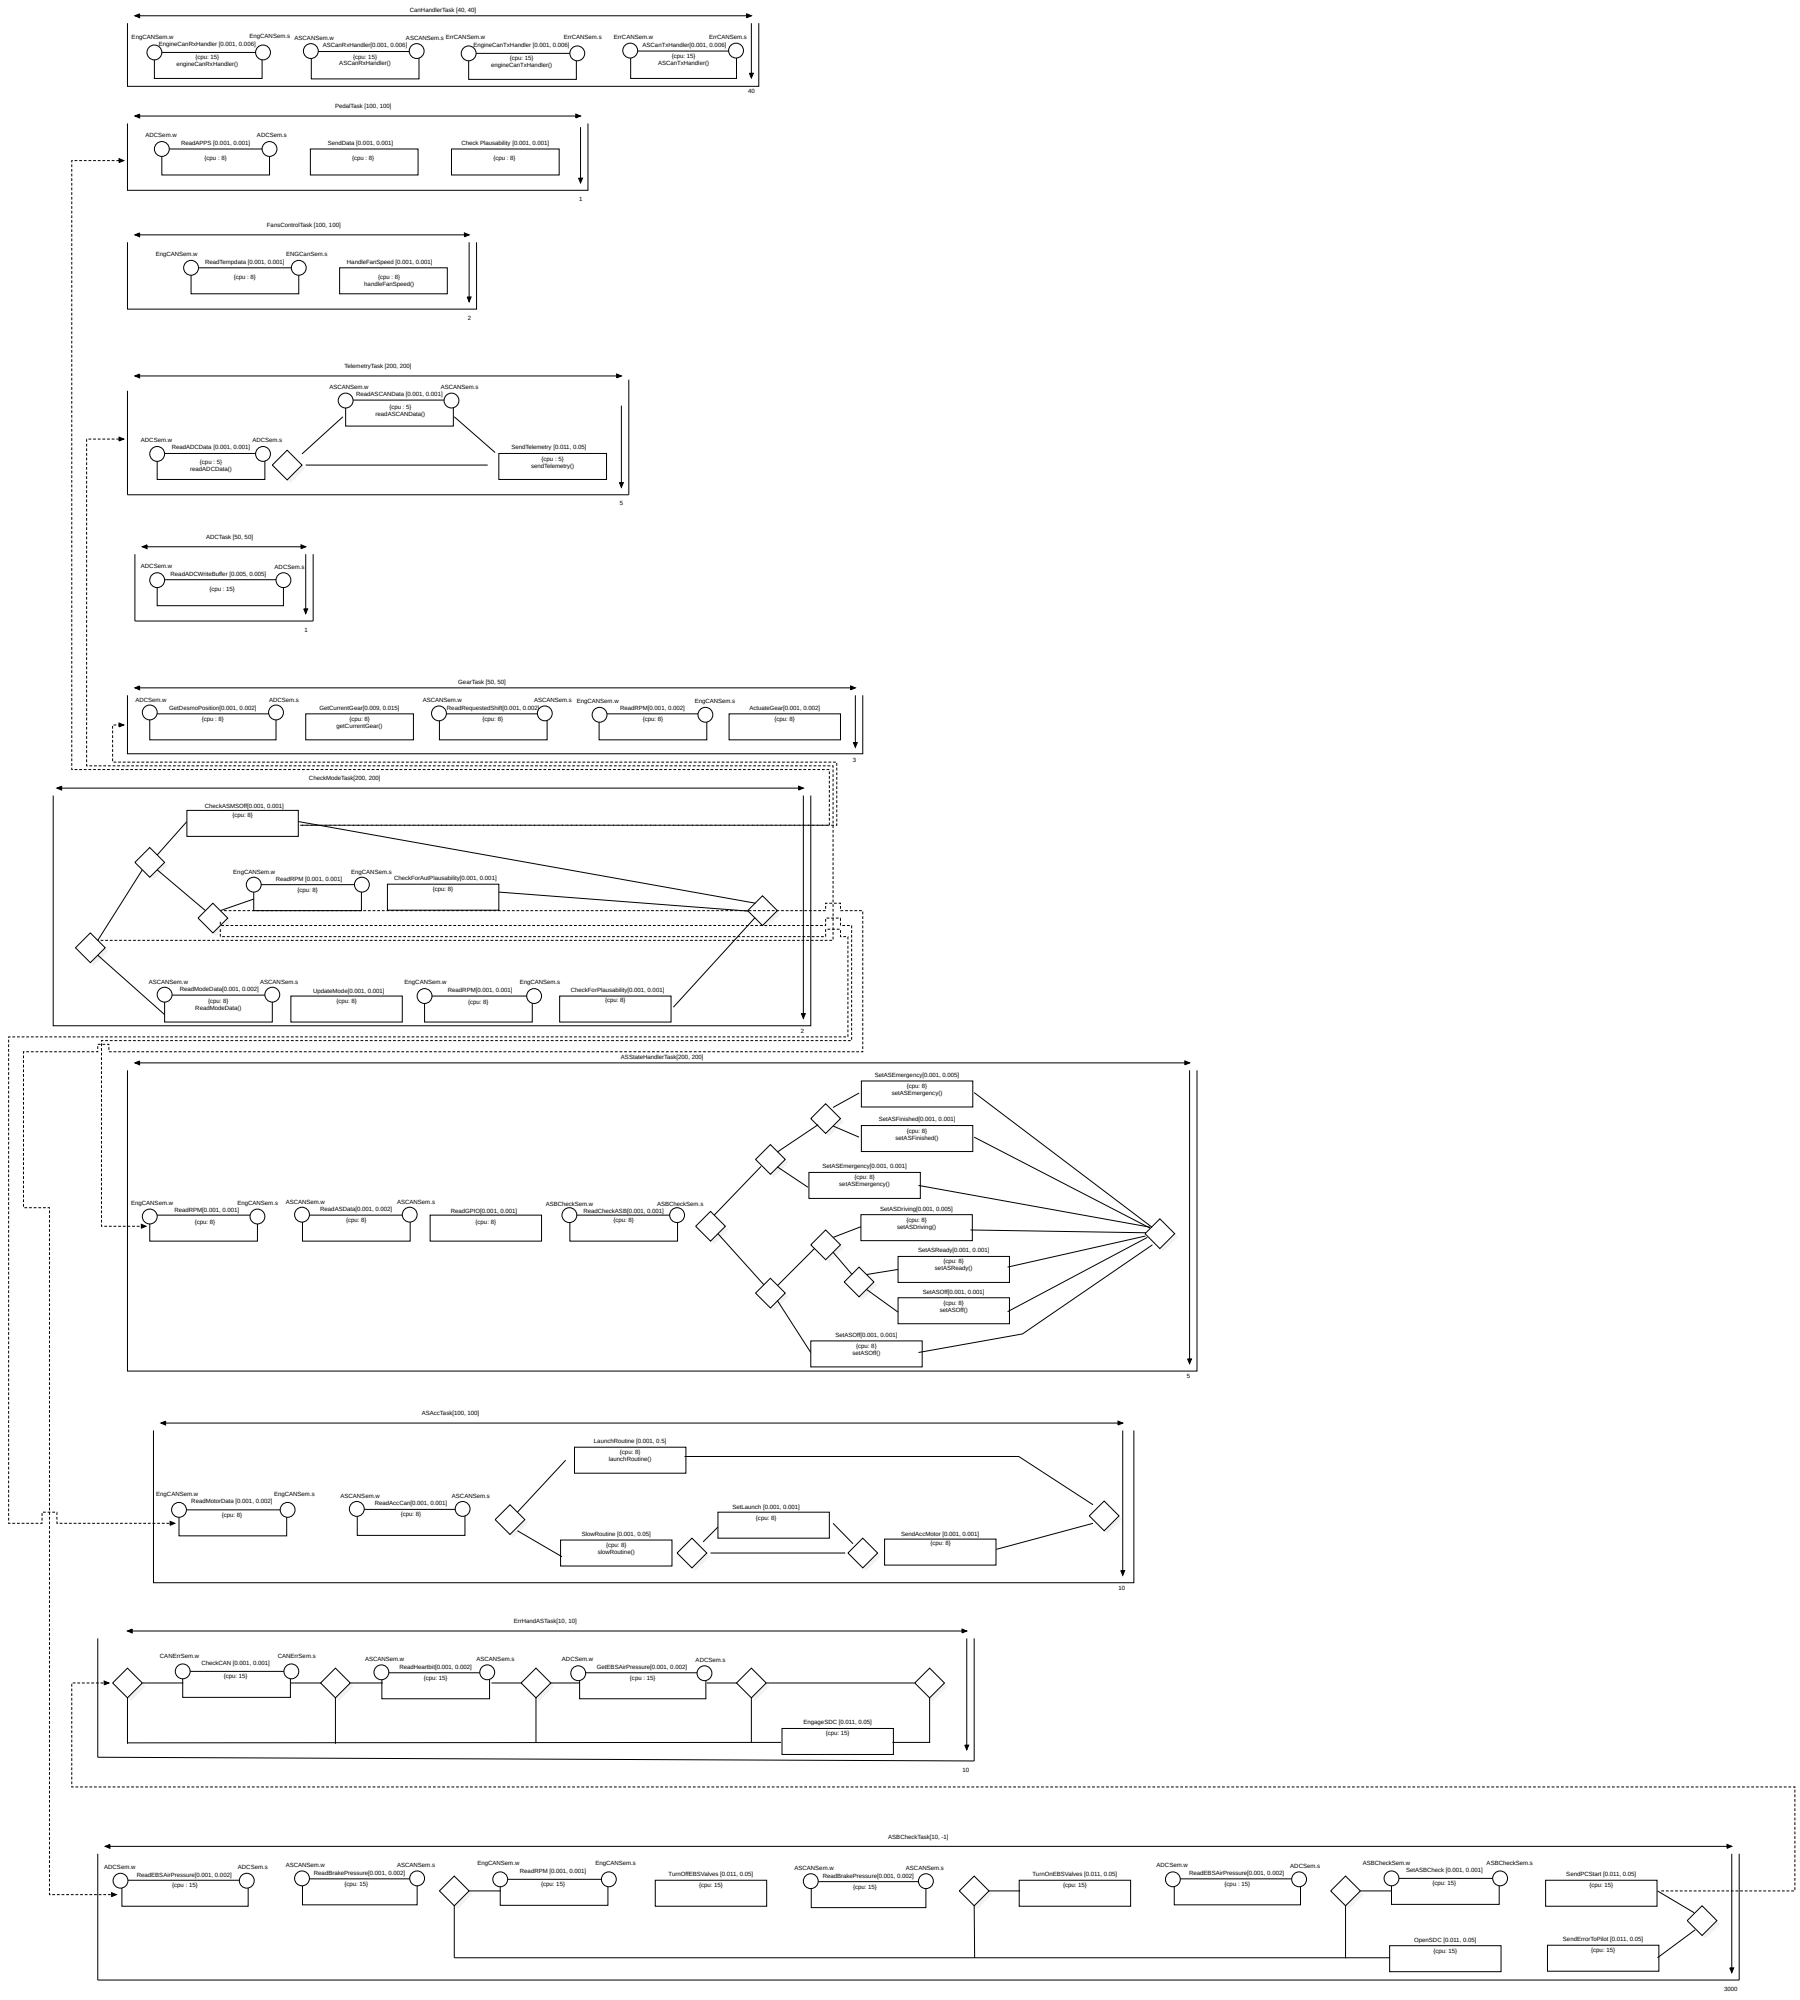
[picture p36: page 1]
{cpu : 8}; EngCANSem.w; ENGCanSem.s; ReadTempdata [0.001, 0.001]; HandleFanSpeed [0.001, 0.001]; SendTelemetry [0.011, 0.05]; {cpu : 5} readADCData(); ADCSem.w; ADCSem.s; ReadADCData [0.001, 0.001]; ReadAPPS [0.001, 0.001]; SendData [0.001, 0.001]; Check Plausability [0.001, 0.001]; PedalTask [100, 100]; FansControlTask [100, 100]; ASCANSem.w; ASCANSem.s; ReadASCANData [0.001, 0.001]; TelemetryTask [200, 200]; {cpu : 15}; ReadADCWriteBuffer [0.005, 0.005]; ADCTask [50, 50]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
