emanuelenencioni/CORE23/Docs/ObjectDiagram.pdf

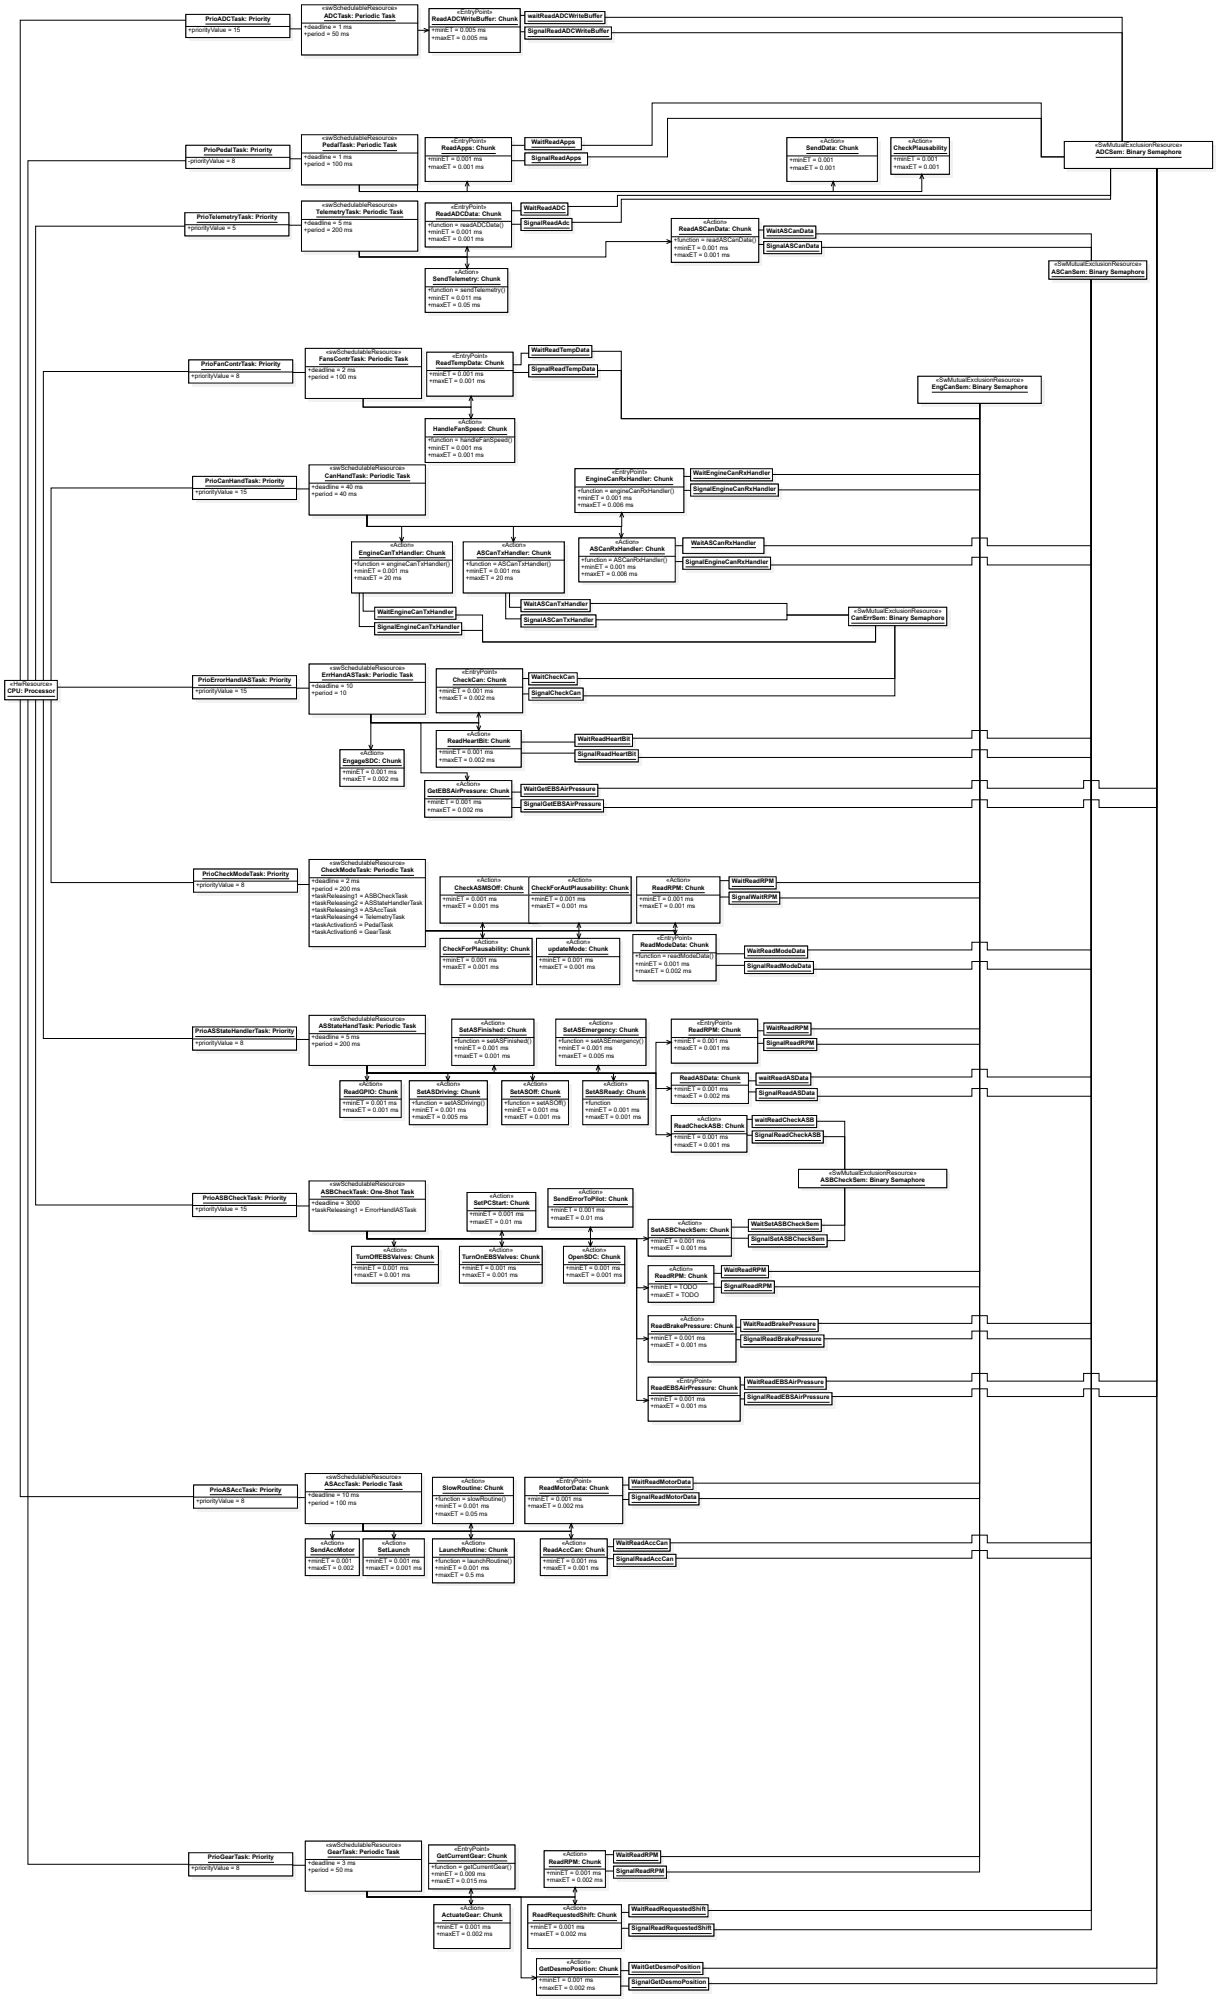
[picture p37: page 1]
«HwResource» CPU: Processor; +deadline = 1 ms +period = 100 ms; PrioPedalTask: Priority; -priorityValue = 8; PrioTelemetryTask: Priority; +priorityValue = 5; +deadline = 5 ms +period = 200 ms; PrioFanContrTask: Priority; +priorityValue = 8; +deadline = 2 ms +period = 100 ms; PrioCanHandTask: Priority; +priorityValue = 15; +deadline = 40 ms +period = 40 ms; PrioADCTask: Priority; +deadline = 1 ms +period = 50 ms; PrioGearTask: Priority; +deadline = 3 ms +period = 50 ms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

«swSchedulableResource»
ADCTask: Periodic Task

PedalTask: Periodic Task

«SwMutualExclusionResource»
ADCSem: Binary Semaphore

TelemetryTask: Periodic Task

ASCanSem: Binary Semaphore

FansContrTask: Periodic Task

EngCanSem: Binary Semaphore

CanHandTask: Periodic Task

CanErrSem: Binary Semaphore

ErrHandASTask: Periodic Task

CheckModeTask: Periodic Task

ASStateHandTask: Periodic Task

ASBCheckSem: Binary Semaphore

ASBCheckTask: One-Shot Task

ASAccTask: Periodic Task

GearTask: Periodic Task
