emanuelenencioni/CORE23/Docs/PTPN/AutonomousPTPN.pdf

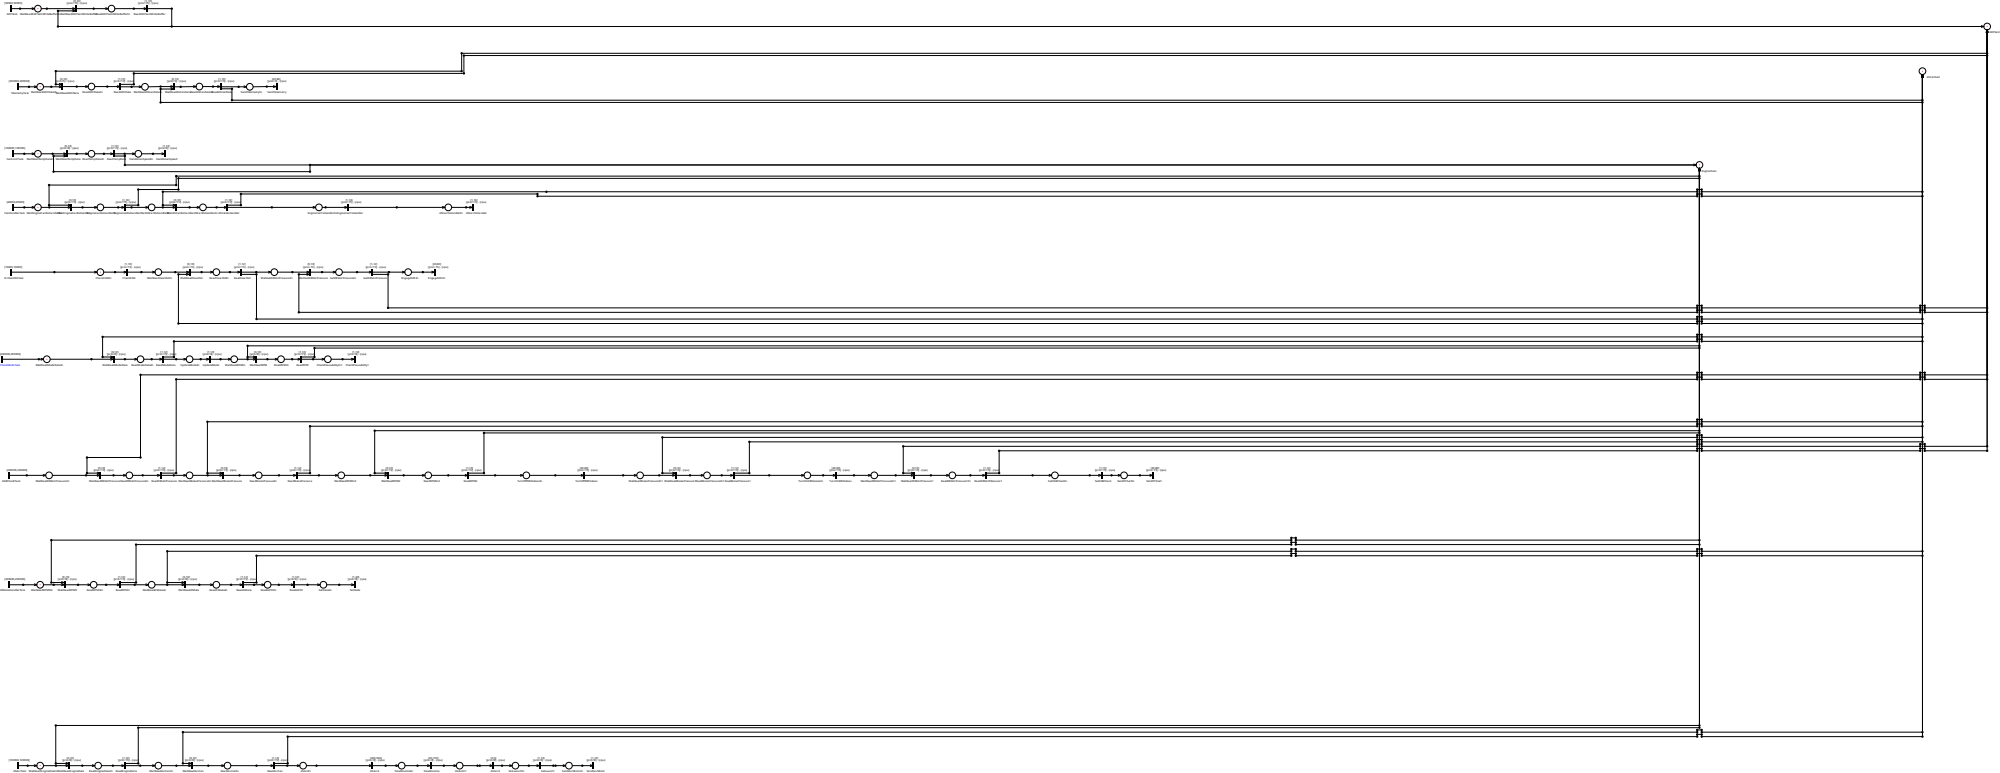
[picture p38: page 1]
WaitReadADCSemWriteBufferIn; ReadADCSemWriteBufferIn; ADCSem; WaitReadADCDataIn; ReadADCDataIn; WaitReadASCanDataIn; ReadASCanDataIn; ASCanSem; SendTelemetryIn; EngCanSem; WaitReadTempDataIn; ReadTempDataIn; HandleFanSpeedIn; WaitEngineCanRxHandlerIn; EngineCanRxHandlerIn; WaitASCanRxHandlerIn; ASCanRxHandlerIn; EngineCanTxHandlerIn; ASCanTxHandlerIn; CheckCANIn; WaitReadHeartbitIn; ReadHeartbitIn; WaitGetEBSAirPressureIn; GetEBSAirPressureIn; EngageSDCIn; WaitReadModeDataIn; ReadModeDataIn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
