emanuelenencioni/CORE23/Core/Src/main.c

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
/* Includes ------------------------------------------------------------------*/
#include "main.h"
#include "cmsis_os.h"

ADC_HandleTypeDef hadc1;
DMA_HandleTypeDef hdma_adc1;

CAN_HandleTypeDef hcan1;
CAN_HandleTypeDef hcan2;

DAC_HandleTypeDef hdac;

SPI_HandleTypeDef hspi3;

TIM_HandleTypeDef htim1;
TIM_HandleTypeDef htim2;
TIM_HandleTypeDef htim3;
TIM_HandleTypeDef htim5;
TIM_HandleTypeDef htim12;

/* Definitions for FansContrTask */
osThreadId_t FansContrTaskHandle;
const osThreadAttr_t FansContrTask_attributes = {
  .name = "FansContrTask",
  .stack_size = 128 * 4,
  .priority = (osPriority_t) osPriorityLow,
};
/* Definitions for DebugTask */
osThreadId_t DebugTaskHandle;
const osThreadAttr_t DebugTask_attributes = {
  .name = "DebugTask",
  .stack_size = 128 * 4,
  .priority = (osPriority_t) osPriorityLow,
};
/* Definitions for PedalTask */
osThreadId_t PedalTaskHandle;
const osThreadAttr_t PedalTask_attributes = {
  .name = "PedalTask",
  .stack_size = 128 * 4,
  .priority = (osPriority_t) osPriorityLow,
};
/* Definitions for GearTask */
osThreadId_t GearTaskHandle;
const osThreadAttr_t GearTask_attributes = {
  .name = "GearTask",
  .stack_size = 128 * 4,
  .priority = (osPriority_t) osPriorityLow,
};
/* Definitions for TelemetryTask */
osThreadId_t TelemetryTaskHandle;
const osThreadAttr_t TelemetryTask_attributes = {
  .name = "TelemetryTask",
  .stack_size = 128 * 4,
  .priority = (osPriority_t) osPriorityLow,
};
/* Definitions for ASAccTask */
osThreadId_t ASAccTaskHandle;
const osThreadAttr_t ASAccTask_attributes = {
  .name = "ASAccTask",
  .stack_size = 128 * 4,
  .priority = (osPriority_t) osPriorityLow,
};
/* Definitions for ErrHandASTask */
osThreadId_t ErrHandASTaskHandle;
const osThreadAttr_t ErrHandASTask_attributes = {
  .name = "ErrHandASTask",
  .stack_size = 128 * 4,
  .priority = (osPriority_t) osPriorityLow,
};
/* Definitions for ASStateHandTask */
osThreadId_t ASStateHandTaskHandle;
const osThreadAttr_t ASStateHandTask_attributes = {
  .name = "ASStateHandTask",
  .stack_size = 128 * 4,
  .priority = (osPriority_t) osPriorityLow,
};
/* Definitions for ASBCheckTask */
osThreadId_t ASBCheckTaskHandle;
const osThreadAttr_t ASBCheckTask_attributes = {
  .name = "ASBCheckTask",
  .stack_size = 128 * 4,
  .priority = (osPriority_t) osPriorityLow,
};
/* Definitions for CheckModeTask */
osThreadId_t CheckModeTaskHandle;
const osThreadAttr_t CheckModeTask_attributes = {
  .name = "CheckModeTask",
  .stack_size = 128 * 4,
  .priority = (osPriority_t) osPriorityLow,
};
/* Definitions for CanHandlerTask */
osThreadId_t CanHandlerTaskHandle;
const osThreadAttr_t CanHandlerTask_attributes = {
  .name = "CanHandlerTask",
  .stack_size = 128 * 4,
  .priority = (osPriority_t) osPriorityLow3,
};
/* Definitions for ADCTask */
osThreadId_t ADCTaskHandle;
const osThreadAttr_t ADCTask_attributes = {
  .name = "ADCTask",
  .stack_size = 128 * 4,
  .priority = (osPriority_t) osPriorityLow,
};
/* Definitions for EngCanSem */
osMutexId_t EngCanSemHandle;
const osMutexAttr_t EngCanSem_attributes = {
  .name = "EngCanSem"
};
/* Definitions for ASCanSem */
osMutexId_t ASCanSemHandle;
const osMutexAttr_t ASCanSem_attributes = {
  .name = "ASCanSem"
};
/* Definitions for ADCSem */
osMutexId_t ADCSemHandle;
const osMutexAttr_t ADCSem_attributes = {
  .name = "ADCSem"
};
/* Definitions for CanErrSem */
osMutexId_t CanErrSemHandle;
const osMutexAttr_t CanErrSem_attributes = {
  .name = "CanErrSem"
};
/* Definitions for ASBCheckSem */
osMutexId_t ASBCheckSemHandle;
const osMutexAttr_t ASBCheckSem_attributes = {
  .name = "ASBCheckSem"
};
void SystemClock_Config(void);
static void MX_GPIO_Init(void);
static void MX_DMA_Init(void);
static void MX_CAN1_Init(void);
static void MX_CAN2_Init(void);
static void MX_DAC_Init(void);
static void MX_SPI3_Init(void);
static void MX_TIM1_Init(void);
static void MX_TIM2_Init(void);
static void MX_TIM3_Init(void);
static void MX_TIM12_Init(void);
static void MX_ADC1_Init(void);
static void MX_TIM5_Init(void);
void fansContrThread(void *argument);
void debugThread(void *argument);
void pedalThread(void *argument);
void gearThread(void *argument);
void telemetryThread(void *argument);
void ASAccThread(void *argument);
void errorHandlerASThread(void *argument);
void ASStateHandlerThread(void *argument);
void ASBCheckThread(void *argument);
void checkModeThread(void *argument);
void canHandlerThread(void *argument);
void ADCThread(void *argument);

/**
  * @brief  The application entry point.
  * @retval int
  */
int main(void)
{
  /* MCU Configuration--------------------------------------------------------*/

  /* Reset of all peripherals, Initializes the Flash interface and the Systick. */
  HAL_Init();

  /* Configure the system clock */
  SystemClock_Config();

  /* Initialize all configured peripherals */
  MX_GPIO_Init();
  MX_DMA_Init();
  MX_CAN1_Init();
  MX_CAN2_Init();
  MX_DAC_Init();
  MX_SPI3_Init();
  MX_TIM1_Init();
  MX_TIM2_Init();
  MX_TIM3_Init();
  MX_TIM12_Init();
  MX_ADC1_Init();
  MX_TIM5_Init();
  /* Init scheduler */
  osKernelInitialize();
  /* Create the mutex(es) */
  /* creation of EngCanSem */
  EngCanSemHandle = osMutexNew(&EngCanSem_attributes);

  /* creation of ASCanSem */
  ASCanSemHandle = osMutexNew(&ASCanSem_attributes);

  /* creation of ADCSem */
  ADCSemHandle = osMutexNew(&ADCSem_attributes);

  /* creation of CanErrSem */
  CanErrSemHandle = osMutexNew(&CanErrSem_attributes);

  /* creation of ASBCheckSem */
  ASBCheckSemHandle = osMutexNew(&ASBCheckSem_attributes);

  /* USER CODE BEGIN RTOS_MUTEX */
  /* add mutexes, ... */
  /* USER CODE END RTOS_MUTEX */

  /* USER CODE BEGIN RTOS_SEMAPHORES */
  /* add semaphores, ... */
  /* USER CODE END RTOS_SEMAPHORES */

  /* USER CODE BEGIN RTOS_TIMERS */
  /* start timers, add new ones, ... */
  /* USER CODE END RTOS_TIMERS */

  /* USER CODE BEGIN RTOS_QUEUES */
  /* add queues, ... */
  /* USER CODE END RTOS_QUEUES */

  /* Create the thread(s) */
  /* creation of FansContrTask */
  FansContrTaskHandle = osThreadNew(fansContrThread, NULL, &FansContrTask_attributes);

  /* creation of DebugTask */
  DebugTaskHandle = osThreadNew(debugThread, NULL, &DebugTask_attributes);

  /* creation of PedalTask */
  PedalTaskHandle = osThreadNew(pedalThread, NULL, &PedalTask_attributes);

  /* creation of GearTask */
  GearTaskHandle = osThreadNew(gearThread, NULL, &GearTask_attributes);

  /* creation of TelemetryTask */
  TelemetryTaskHandle = osThreadNew(telemetryThread, NULL, &TelemetryTask_attributes);

  /* creation of ASAccTask */
  ASAccTaskHandle = osThreadNew(ASAccThread, NULL, &ASAccTask_attributes);

  /* creation of ErrHandASTask */
  ErrHandASTaskHandle = osThreadNew(errorHandlerASThread, NULL, &ErrHandASTask_attributes);

  /* creation of ASStateHandTask */
  ASStateHandTaskHandle = osThreadNew(ASStateHandlerThread, NULL, &ASStateHandTask_attributes);

  /* creation of ASBCheckTask */
  ASBCheckTaskHandle = osThreadNew(ASBCheckThread, NULL, &ASBCheckTask_attributes);

  /* creation of CheckModeTask */
  CheckModeTaskHandle = osThreadNew(checkModeThread, NULL, &CheckModeTask_attributes);

  /* creation of CanHandlerTask */
  CanHandlerTaskHandle = osThreadNew(canHandlerThread, NULL, &CanHandlerTask_attributes);

  /* creation of ADCTask */
  ADCTaskHandle = osThreadNew(ADCThread, NULL, &ADCTask_attributes);

  /* USER CODE BEGIN RTOS_THREADS */
  /* add threads, ... */
  // Always before kernel start, shutdown CMD should be always on
  HAL_GPIO_WritePin(SHUTDOWN_CMD_GPIO_Port, SHUTDOWN_CMD_Pin, SET);

  vTaskSuspend(ASStateHandTaskHandle);
  vTaskSuspend(ASBCheckTaskHandle);
  vTaskSuspend(TelemetryTaskHandle);
  vTaskSuspend(ErrHandASTaskHandle);
  vTaskSuspend(PedalTaskHandle);
  vTaskSuspend(GearTaskHandle);

  /* USER CODE END RTOS_THREADS */

  /* USER CODE BEGIN RTOS_EVENTS */
  /* add events, ... */
  /* USER CODE END RTOS_EVENTS */

  /* Start scheduler */
  osKernelStart();

  /* We should never get here as control is now taken by the scheduler */
  /* Infinite loop */
  /* USER CODE BEGIN WHILE */


 
  
  


  while (1)
  {
    /* USER CODE END WHILE */

    /* USER CODE BEGIN 3 */
  }
  /* USER CODE END 3 */
}

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
/* USER CODE BEGIN Header_fansContrThread */
/**
  * @brief  Function implementing the FansContrTask thread.
  * @param  argument: Not used
  * @retval None
  */
/* USER CODE END Header_fansContrThread */
__weak void fansContrThread(void *argument)
{
  /* USER CODE BEGIN 5 */
  /* Infinite loop */
  for(;;)
  {
    osDelay(1);
  }
  /* USER CODE END 5 */
}

/* USER CODE BEGIN Header_debugThread */
/**
* @brief Function implementing the DebugTask thread.
* @param argument: Not used
* @retval None
*/
/* USER CODE END Header_debugThread */
__weak void debugThread(void *argument)
{
  /* USER CODE BEGIN debugThread */
  /* Infinite loop */
  for(;;)
  {
    osDelay(1);
  }
  /* USER CODE END debugThread */
}

/* USER CODE BEGIN Header_pedalThread */
/**
* @brief Function implementing the PedalTask thread.
* @param argument: Not used
* @retval None
*/
/* USER CODE END Header_pedalThread */
__weak void pedalThread(void *argument)
{
  /* USER CODE BEGIN pedalThread */
  /* Infinite loop */
  for(;;)
  {
    osDelay(1);
  }
  /* USER CODE END pedalThread */
}

/* USER CODE BEGIN Header_gearThread */
/**
* @brief Function implementing the GearTask thread.
* @param argument: Not used
* @retval None
*/
/* USER CODE END Header_gearThread */
__weak void gearThread(void *argument)
{
  /* USER CODE BEGIN gearThread */
  /* Infinite loop */
  for(;;)
  {
    osDelay(1);
  }
  /* USER CODE END gearThread */
}

/* USER CODE BEGIN Header_telemetryThread */
/**
* @brief Function implementing the TelemetryTask thread.
* @param argument: Not used
* @retval None
*/
/* USER CODE END Header_telemetryThread */
__weak void telemetryThread(void *argument)
{
  /* USER CODE BEGIN telemetryThread */
  /* Infinite loop */
  for(;;)
  {
    osDelay(1);
  }
  /* USER CODE END telemetryThread */
}

/* USER CODE BEGIN Header_ASAccThread */
/**
* @brief Function implementing the ASAccTask thread.
* @param argument: Not used
* @retval None
*/
/* USER CODE END Header_ASAccThread */
__weak void ASAccThread(void *argument)
{
  /* USER CODE BEGIN ASAccThread */
  /* Infinite loop */
  for(;;)
  {
    osDelay(1);
  }
  /* USER CODE END ASAccThread */
}

/* USER CODE BEGIN Header_errorHandlerASThread */
/**
* @brief Function implementing the ErrHandASTask thread.
* @param argument: Not used
* @retval None
*/
/* USER CODE END Header_errorHandlerASThread */
__weak void errorHandlerASThread(void *argument)
{
  /* USER CODE BEGIN errorHandlerASThread */
  /* Infinite loop */
  for(;;)
  {
    osDelay(1);
  }
  /* USER CODE END errorHandlerASThread */
}

/* USER CODE BEGIN Header_ASStateHandlerThread */
/**
* @brief Function implementing the ASStateHandTask thread.
* @param argument: Not used
* @retval None
*/
/* USER CODE END Header_ASStateHandlerThread */
__weak void ASStateHandlerThread(void *argument)
{
  /* USER CODE BEGIN ASStateHandlerThread */
  /* Infinite loop */
  for(;;)
  {
    osDelay(1);
  }
  /* USER CODE END ASStateHandlerThread */
}

/* USER CODE BEGIN Header_ASBCheckThread */
/**
* @brief Function implementing the ASBCheckTask thread.
* @param argument: Not used
* @retval None
*/
/* USER CODE END Header_ASBCheckThread */
__weak void ASBCheckThread(void *argument)
{
  /* USER CODE BEGIN ASBCheckThread */
  /* Infinite loop */
  for(;;)
  {
    osDelay(1);
  }
  /* USER CODE END ASBCheckThread */
}

/* USER CODE BEGIN Header_checkModeThread */
/**
* @brief Function implementing the CheckModeTask thread.
* @param argument: Not used
* @retval None
*/
/* USER CODE END Header_checkModeThread */
__weak void checkModeThread(void *argument)
{
  /* USER CODE BEGIN checkModeThread */
  /* Infinite loop */
  for(;;)
  {
    osDelay(1);
  }
  /* USER CODE END checkModeThread */
}

/* USER CODE BEGIN Header_canHandlerThread */
/**
* @brief Function implementing the CanHandlerTask thread.
* @param argument: Not used
* @retval None
*/
/* USER CODE END Header_canHandlerThread */
__weak void canHandlerThread(void *argument)
{
  /* USER CODE BEGIN canHandlerThread */
  /* Infinite loop */
  for(;;)
  {
    osDelay(1);
  }
  /* USER CODE END canHandlerThread */
}

/* USER CODE BEGIN Header_ADCThread */
/**
* @brief Function implementing the ADCTask thread.
* @param argument: Not used
* @retval None
*/
/* USER CODE END Header_ADCThread */
__weak void ADCThread(void *argument)
{
  /* USER CODE BEGIN ADCThread */
  /* Infinite loop */
  for(;;)
  {
    osDelay(1);
  }
  /* USER CODE END ADCThread */
}

/**
  * @brief  Period elapsed callback in non blocking mode
  * @note   This function is called  when TIM6 interrupt took place, inside
  * HAL_TIM_IRQHandler(). It makes a direct call to HAL_IncTick() to increment
  * a global variable "uwTick" used as application time base.
  * @param  htim : TIM handle
  * @retval None
  */
void HAL_TIM_PeriodElapsedCallback(TIM_HandleTypeDef *htim)
{
  if (htim->Instance == TIM6) {
    HAL_IncTick();
  }
}

/**
  * @brief  This function is executed in case of error occurrence.
  * @retval None
  */
void Error_Handler(void)
{
  /* USER CODE BEGIN Error_Handler_Debug */
  /* User can add his own implementation to report the HAL error return state */
  __disable_irq();
  while (1)
  {
  }
  /* USER CODE END Error_Handler_Debug */
}

#ifdef  USE_FULL_ASSERT
/**
  * @brief  Reports the name of the source file and the source line number
  *         where the assert_param error has occurred.
  * @param  file: pointer to the source file name
  * @param  line: assert_param error line source number
  * @retval None
  */
void assert_failed(uint8_t *file, uint32_t line)
{
  /* USER CODE BEGIN 6 */
  /* User can add his own implementation to report the file name and line number,
     ex: printf("Wrong parameters value: file %s on line %d\r\n", file, line) */
  /* USER CODE END 6 */
}
#endif /* USE_FULL_ASSERT */
