emanuelenencioni/CORE23/(commit log)

2023-12-21 added gear telem fan tasks to AD
2024-02-01 finished Obj diag. for GearTask
2024-02-01 Changed to DMA
2024-02-06 removed Interrupt handlers
2024-02-06 removed int handler and changed prio to dma
2024-02-12 Fixed ASCAN and filters.
    [CanHandlerTask.c, CanHandlerTask.h]
2024-02-13 Updated ioc with fixes for CAN
    [CORE23.ioc]
2024-02-16 fixed name and diagram CanHandlerTask
    [CanHandlerTask.c, CanHandlerTask.h]
2024-02-20 added tim1 and fixed other tim
    [CORE23.ioc, main.c]
2024-02-20 Added Fan task
2024-02-21 removed pwm for assi leds
2024-02-21 tested ASStateHandler, fixed fantask. added stuff in canHandler
    [ASSTateHandTask.h, ASStateHandTask.c, CanHandlerTask.c, CanHandlerTask.h, CheckModeTask.c, FanTask.c]
2024-02-22 Update Gear, Acc & Fan
2024-02-22 Updated Gear Task
2024-02-22 added logging error in can
    [ErrHandASTask.c]
2024-02-22 created and tested ASBCheckTask. fixed errors, updated README
    [ASBCheckTask.c, ASStateHandTask.c, CheckModeTask.c]
2024-02-23 added clutch, added new pin for ebs.
2024-02-23 gearTask Completed
2024-02-26 Added encoder wheels
2024-02-26 Updated TelemetryTask and GearTask
2024-02-26 Updated CanHandlerTask and ADC Variables
2024-02-26 Added LoRa, Modified TelemetryTask and Gear
2024-02-27 added chunks in code, fixed obj diag
    [ADCTask.c, FanTask.c]
2024-02-28 Fixed and Finished diag for GearTask
    [GearTask.c]
2024-02-28 fixing and finished diag for CanHandlerTask and CheckModeTask
    [CanHandlerTask.c, CheckModeTask.c]
2024-02-28 Fixed CheckModeTask, added reqStart in ASBuffer
    [CanHandlerTask.h, CheckModeTask.c]
2024-02-29 fixed code, added ET for some tasks
    [ADCTask.c, ADCTask.h, CORE23.ioc, PedalTask.c]
2024-03-01 fixed and refactor tasks
    [CanHandlerTask.c, CheckModeTask.c, CheckModeTask.h, FansContrTask.c, GearTask.c, TelemetryTask.c, TelemetryTask.h]
2024-03-04 added timeline for GearTask
2024-03-14 updated readme with brake light handling
2024-03-18 added range and front back brake sensors
2024-03-18 added range of EBS and Brake pressure
2024-03-18 correcting range EBS Air
    [ErrHandASTask.c]
2024-03-20 added correct range of EBSAir sensors, added docs too
    [ADCTask.c, ADCTask.h]
2024-03-28 Adjusted brakepressure name and source.
2024-03-29 added RES_STATUS pin
